santihofi/lit_compac_sky/macros/gilbert_cell/README.md

# gilbert_cell

Initial SKY130 schematic under characterization, not released for layout.
The conversion source is scripts/port_core_schematic.py at the repository root, with explicit sizing overrides in doc/porting/core_sizing.json when present.
See doc/porting/COMPARISON.md for measured candidates and qualification gaps.
No inherited IHP layout is a SKY130 deliverable.
