santihofi/lit_compac_sky/doc/porting/REVIEW-2026-11-10.md

# Input-2 evidence and bench review, 2026-11-10

The creator and independent reviewer were separate Codex agents using the same available model.
The runtime did not expose a more specific model revision.
This is an independent same-model review, not a stronger-model or cross-vendor review.

The reviewer read the scripts and raw Chipify outputs directly.
All 1440 older transmission-gate PVT rows matched the retained evidence.
The SS code search had three valid cases, 111 scalar measurements and twelve independently anchored AC curves.
Selected nominal results matched their raw runs.
Removing the loop probes and reconnecting split nodes restored the quiet-replica circuit for both benches.
Both main and replica tail gates are on the loaded side of the local bias probe.

Findings and changes:

- A failed future SS search could leave an old selected-code file. The analyzer now removes the previous selection before writing a new feasible selection.
- The loop analyzer did not require all five corners or match the selected parameter tuples. It now checks both, and the generator reads selected codes from the evidence.
- The new tuple check initially removed corner_mos from its indexed row. Keeping that column fixes the resulting KeyError.
- The PVT report called the measured tail-gate quantity a trim-gate rail. The wording now names the actual measured node.

The independent reviewer also reconstructed both FF and FS loop margins from their captured curves and found one unity crossing for each.
The PVT auditor now checks every declared parameter, including the defining quiet-replica geometry and mode, and reproduces the older 1440-case audit.
The reviewer subsequently anchored SF and SS too. The primary audit anchored all ten curves, but the separate TT review could not run because the reviewer reached its usage limit. The same independent reviewer completed the TT check on 2026-11-11, with no discrepancy.
On 2026-11-11 the reviewer checked all 1440 raw PVT rows, parameter grids and 45 coverage sets. The 32/45 DC coverage and thirteen-hole classification agree. Full-spec qualification remains open.

On 2026-11-11 the independent reviewer verified that the bias-sensitivity deck differs only in both ideal current sources and the tail-ratio normalization.
The generated grid contains the intended 150 cases at thirteen holes, including thirty factor-one controls.
A potential vacuous replay pass was found if a future datasheet omitted factor one.
The analyzer now requires the complete intended tuple set derived independently from the baseline coverage summary.

The independent reviewer also checked the refinement and resistor-range generators against the validated bias deck.
Refinement has fourteen cases and two repeated controls.
The resistor study has 180 cases across ten points, nine fixed/trim combinations and twenty repeated controls.
The endpoint analyzer reports gain span diagnostics and retains full-spec coverage as unverified.

The independent reviewer recomputed the final 40/45 DC union and all fourteen refinement rows with no numerical discrepancy.
The narrow TT shape margin is retained explicitly.
A robustness suggestion expanded the union's identity checks to every declared baseline parameter, including remaining transistor dimensions, passive models and reference conditions.

The independent reviewer checked all 180 resistor-range rows, twenty controls and ninety endpoint diagnostics with no discrepancy.
The proposed global 0.8 / 1.4 follow-up received an independent experimental-design review.
Separate review of its implementation remains pending because the reviewer reached its usage limit.
The primary checks confirm 322 generated cases, an unchanged circuit deck and unchanged parameters outside the intended resistor, code and bias fields.
Both preceding analyzer modes still reproduce their completed results.

The independent reviewer later completed the widened-network implementation and result review.
All 322 raw rows, twenty controls and ten all-code verdicts match the evidence.
The reviewer also checked the eight-code nominal AC generator and analyzer, including current substitutions, DC replay, four curves per code and matched IHP references.
No implementation defects were found. Numerical AC results remain pending.

The independent reviewer verified all eight widened-network AC rows, DC replays and 32 anchored curves.
Only FF and SF have a nominal joint pass at the tested currents.
The trim-poly diagnostic also passed independent topology review: all three decks are unchanged outside gain_trim, and exactly 35 resistor instances use resistance-matched family substitutions.
The reviewer confirmed both positive lengths and exact algebraic reduction of the wide-family replay equation.

The independent reviewer verified the four FS trim-poly rows, two wide-family replays, sixteen waveform anchors and both narrow-family joint passes.
The primitive probe implementation, model equations, lengths and capacitance sign convention were reviewed, but the reviewer did not independently replay that primitive simulation.
The sixteen-case corner extension and its complete tuple, replay and capture checks also passed implementation review.

On 2026-11-12 the independent reviewer verified all sixteen trim-corner rows, eight wide-family controls and 64 anchored curves.
The four-of-five nominal joint verdict agrees with the evidence.
SS remains below the bare and loaded input-2 references at both sampled codes.
The reviewer endorsed the finite SS gain/current search as a calibration experiment, with AC required at every DC-feasible setting before a joint verdict.

The independent reviewer verified the completed SS AC intersection and the active-pair sensitivity controls.
All four SS settings fail input-2 speed, with sixteen anchored curves and both old-current controls reproduced.
The four pair-width rows, two scale-one controls and sixteen curves also match the raw data.
The smaller-pair recalibration generator and DC analyzer passed implementation review, including the full 32-code grid and unchanged baseline parameters.

The independent reviewer verified both smaller-pair matched-gain AC rows, two DC replays and eight anchored curves.
Both SS codes pass the joint screen, with no inherited coverage from other geometries.
The twenty-case global endpoint generator and analyzer also passed implementation review, including fixed dummy loading, current settings, complete tuples and two SS endpoint controls.
