santihofi/lit_compac_sky/doc/porting/figures/input2_improvement.pdf

ff | fs | sf | ss | tt

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
Input-2 bandwidth / matched IHP bandwidth

100 fF per output, nominal MOS corners

2 copies, 5.73 µm fixed loads 6 copies, 1.41 µm fixed loads

in1
25 fF

in1
50 fF

in2
25 fF

in2
50 fF
Receiver input and wire capacitance per output

0.0

0.2

0.4

0.6

0.8

1.0

Input-2 bandwidth / matched IHP bandwidth

Slow corner, 1.41 µm loads in both variants

2 copies, identical receiver
6 copies, identical receiver

Six copies cost about 3× supply current and input capacitance versus two copies
