santihofi/lit_compac_sky/doc/README.md

# Documentation

Reference material for this chip and for the SkyWater sky130A Open-PDK it is built on.

## This chip

| Document | Contents |
| --- | --- |
| [specifications.md](specifications.md) | Top-level specifications: technology, supplies, clock, corner list, macro inventory, functional behaviour of every block. |
| [pinout.md](pinout.md) | The full 32-pad table per side, with the `lit_compac_top` port, the pad cell and the role each pad carries inside `lit_compac_core`. |
| [floorplan.md](floorplan.md) | Die and core geometry, hard-macro placement coordinates, the PDN strategy and the pad ring. |

The three are cross-linked and are written against the design files, not the other way round. If you change a number in [flow/librelane/config.yaml](../flow/librelane/config.yaml), [rtl/](../rtl/) or [packaging/config.yaml](../packaging/config.yaml), mirror it here.

## Tools

| Document | Contents |
| --- | --- |
| [klayout/klayout_cheatsheet.md](klayout/klayout_cheatsheet.md) | KLayout for this PDK: shortcuts, the `skywater130` PCell list, layer roles, the DRC and LVS menu entries and where they write. |
| [librelane/librelane_cheatsheet.md](librelane/librelane_cheatsheet.md) | LibreLane `final/` directory anatomy, non-default routing rules, the sky130A via and metal-stack tables read out of the tech LEF, the eight LEF/DEF orientations. |
| [verilog/](verilog/) | Verilog and SystemVerilog cheatsheets (external documents, PDK-independent). |

## PDK

| Document | Contents |
| --- | --- |
| [sky130A-Open-PDK/README.md](sky130A-Open-PDK/README.md) | Where the sky130 documentation lives, which commit of it this template was built against, and the layout numbers that matter, read out of the installed PDK. |
| [sky130A-Open-PDK/sky130A_ngspice_mc_mm_guide.md](sky130A-Open-PDK/sky130A_ngspice_mc_mm_guide.md) | How the ngspice model files fit together, what the `mc_mm_switch` and `mc_pr_switch` parameters do, and which corner, Monte Carlo and mismatch runs are possible per device family. |
| [sizing/](sizing/) | gm/ID techsweep plot overviews for the 1.8 V and 5 V MOS devices, the data behind the sizing notebooks in [macros/inverter/scripts/sizing/](../macros/inverter/scripts/sizing/). |

## Provenance and caveats

- **The PDK itself carries no PDF documentation.** sky130A has no `libs.doc/` folder, unlike the IHP PDKs, so this folder links the online documentation instead of copying it. The version this template was measured against is in [sky130A-Open-PDK/README.md](sky130A-Open-PDK/README.md): open_pdks `026824c7969ce6f4fc9678e6ca04b0a06a596c4b`, the PDK of the IIC-OSIC-TOOLS 2026.08 image.
- **Numbers here come from the installed PDK, not from a datasheet.** The metal stack table in the LibreLane cheatsheet is read out of `sky130_fd_sc_hd__nom.tlef`, the PCell list out of `libs.tech/klayout/python/cells/`, the corner sections out of `libs.tech/ngspice/sky130.lib.spice`. Re-read them after a PDK update, the commands are in each document.
- **Nothing in `doc/` is generated by a make target.** It is all hand-maintained, except the plot overviews in `sizing/`, which come from the techsweep data.
