santihofi/lit_compac_sky/ip/sky130_ip__jku/README.md

# sky130_ip__jku

A logo IP block for [Johannes Kepler University Linz](https://www.jku.at/), rendered as a GDSII layout on a configurable metal layer (default `met4`) for the SkyWater sky130A 130 nm CMOS process, framed by the `prBoundary` layer. sky130 has no fill keep-out layer like IHP's `NoMetFiller`, the chip flow handles the fill around the block.

## Directory Structure

<details>
<summary>Show Directory Structure</summary>

```text
📁 sky130_ip__jku/
├─ Makefile                   # Build automation
├─ 📁 logo/
│  └─ jku_logo.png            # Source PNG image
├─ 📁 script/
│  └─ img2lay.py              # PNG-to-GDS converter
├─ 📁 final/
│  ├─ 📁 gds/
│  │  └─ sky130_ip__jku.gds   # Generated GDSII layout
│  ├─ 📁 lef/
│  │  └─ sky130_ip__jku.lef   # LEF macro for place-and-route
│  ├─ 📁 lib/
│  │  └─ sky130_ip__jku.lib   # Liberty timing stub
│  └─ 📁 vh/
│     └─ sky130_ip__jku.vh    # Verilog blackbox stub
└─ 📁 verification/
   └─ 📁 drc/                 # DRC reports
```

</details>

## Usage

The default Make target is `help`, so running `make` prints usage and all available targets with short descriptions.

```bash
make
make help
```

Build everything (clean, generate logo GDS, LEF, Liberty, Verilog stub, run DRC):

```bash
make all
```

### PDK Guard

Every target except `help` and `clean` needs the `sky130A` PDK. A wrong `$PDK`, for example `ihp-sg13g2` from the sibling IHP template, splits the IP across two technologies: `img2lay.py` resolves the `LAYER` name through the layer properties of the active PDK, and `sak-drc.sh` runs the DRC against its rule deck, while the metal stack the logo is meant for is the sky130 one. The Makefile therefore compares `$PDK` against `REQUIRED_PDK` once when it is parsed, before any target runs:

```bash
$ sak-pdk ihp-sg13g2
$ make all
Makefile:21: *** PDK is "ihp-sg13g2", but this IP needs "sky130A". Run `sak-pdk sky130A` in this shell and retry, or pass REQUIRED_PDK= to skip this check.  Stop.
```

The check is a parse-time conditional at the top of the Makefile, not a prerequisite of each target. Switch the PDK with `sak-pdk sky130A`, pass `REQUIRED_PDK=` to skip the check, or `REQUIRED_PDK=<pdk>` to require a different PDK.

### Individual Targets

| Target | Description |
|---|---|
| `logo` | Convert PNG to GDSII using `img2lay.py` |
| `lef` | Generate LEF macro (CLASS BLOCK, OBS on `$(LAYER)`) |
| `lib` | Generate Liberty timing stub (empty cell) |
| `verilog` | Generate Verilog blackbox stub (no ports) |
| `klayout-drc` | Run KLayout DRC using `sak-drc.sh` (usage: `make klayout-drc [CELL=<cellname>] [DRC_LEVEL=<precheck\|macro\|regular>]`) |
| `magic-drc` | Run Magic DRC using `sak-drc.sh` (usage: `make magic-drc [CELL=<cellname>]`) |
| `open` | Browse this folder with `sak-open.py` and open each file in its tool |
| `clean` | Remove all generated output directories |

### Parameters

The following Makefile variables can be overridden:

| Variable | Default  | Description |
|---|---|---|
| `BLOCK_SIZE`  | `100` | Block edge in µm, the image is scaled to it |
| `PIXEL_SIZE`  | `0.50` | Pixel size in µm (must be ≥ 0.3 µm, the `met4` minimum width and space, single pixels and single-pixel gaps are drawn as is; `met5` needs 1.6 µm) |
| `LAYER` | `met4` | Metal layer the logo is drawn on, one of `met1`..`met5` |

Setting `LAYER` keeps the GDS artwork (`logo` target) and the LEF obstruction (`lef` target) consistent. The `logo` target hands the name to `img2lay.py`, which resolves it through the PDK's KLayout layer properties (`met4` is `71/20`), and the `lef` target writes the same name into the `OBS`.

```sh
make all LAYER=met5 PIXEL_SIZE=2
```

The image is scaled to `BLOCK_SIZE`, so the GDS boundary and the LEF `SIZE` always agree.

## Logo Generator Script

The `script/img2lay.py` script converts a PNG image into a GDSII layout:

- Each horizontal run of dark pixels becomes a rectangle on the layer selected via `LAYER` (default `met4`, resolved to `71/20`)
- The boundary layer `prBoundary` (235/4) marks the block outline
- Layers are given as `<layer>/<datatype>` or as a layer name of the active PDK, read from `$PDK_ROOT/$PDK/libs.tech/klayout/tech/<pdk>.lyp`. sky130A names its entries `met4.drawing - 71/20`, a bare name selects the drawing purpose (or the only purpose, `prBoundary` is `prBoundary.boundary`), `<layer>.<purpose>` selects any other
- `--invert` inverts the image (dark ↔ light)
- `--merge` merges the rectangles into polygons to reduce the polygon count
- `--pixel-size` sets the physical size of each pixel in µm
- `--block-size` scales the image to the given block edge in µm and draws the boundary layers at that size
- `--scale` downscales the image by a plain factor instead

## Design Rule Check (DRC)

Runs DRC on the GDS layout in `final/gds/`. Both flows use `sak-drc.sh` and write to `verification/drc/`: Magic into the run folder `verification/drc/<CELL>.magic.drc/` (`<CELL>.magic.drc.rpt`), KLayout directly into `verification/drc/` as one marker database and log per deck, `<CELL>.klayout.drc.<deck>.xml` and `.log` with `<deck>` being `feol`, `beol`, `pincheck` or `zeroarea`.

**KLayout DRC** uses `sak-drc.sh` at the selected `DRC_LEVEL` (`precheck`, `macro` [default], or `regular`):

```sh
make klayout-drc
make klayout-drc CELL=sky130_ip__jku
make klayout-drc DRC_LEVEL=regular
```

**Magic DRC** uses `sak-drc.sh`:

```sh
make magic-drc
make magic-drc CELL=sky130_ip__jku
```
