santihofi/lit_compac_sky/doc/porting/figures/ihp_core_transfer.pdf

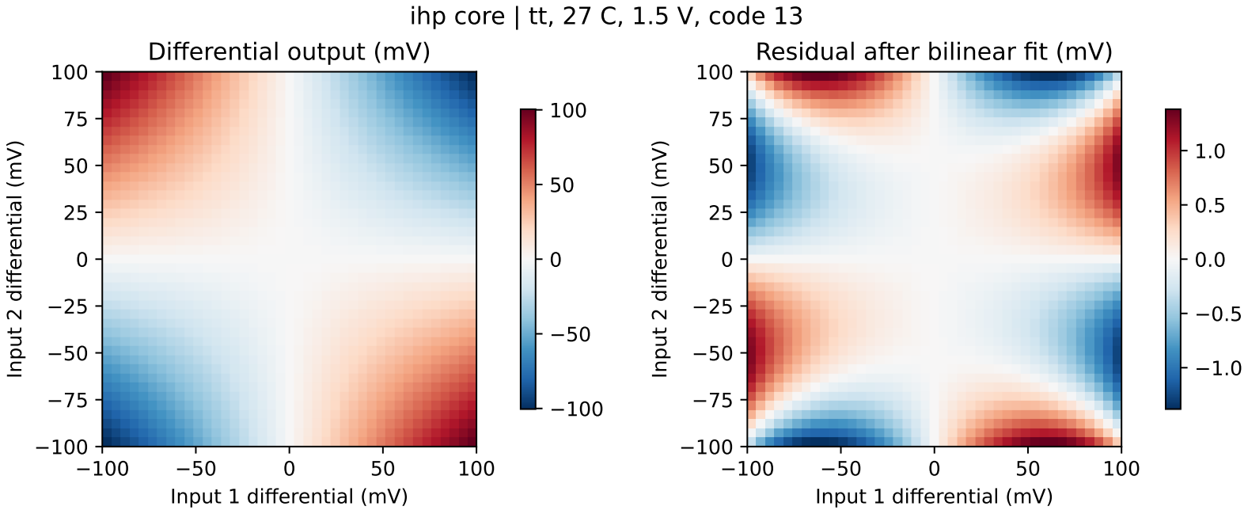
[picture p19: page 1]

−100 | −50 | 0 | 50 | 100
Input 1 differential (mV)

−100

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
Input 2 di

fferential (mV)

### Differential output (mV)

−100 | −50 | 0 | 50 | 100
Input 1 differential (mV)

−100

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
Input 2 di

fferential (mV)

### Residual after bilinear fit (mV)

−100

−50

0

50

100

−1.0

−0.5

0.0

0.5

1.0

### ihp core | tt, 27 C, 1.5 V, code 13
