santihofi/lit_compac_sky/doc/porting/figures/ihp_surface_corners.png

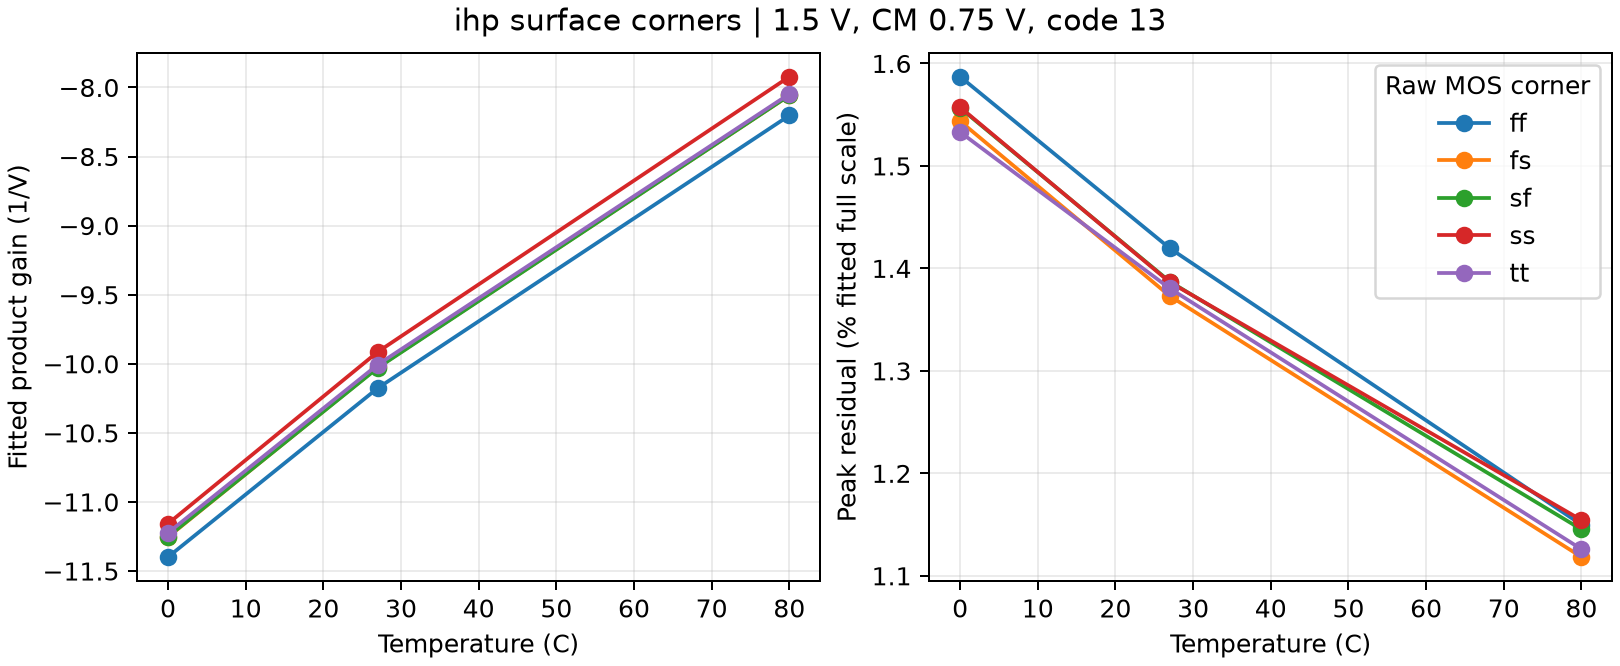
doc/porting/figures/ihp_surface_corners.png
