santihofi/lit_compac_sky/doc/porting/figures/replica_schematic_gain_trim.png

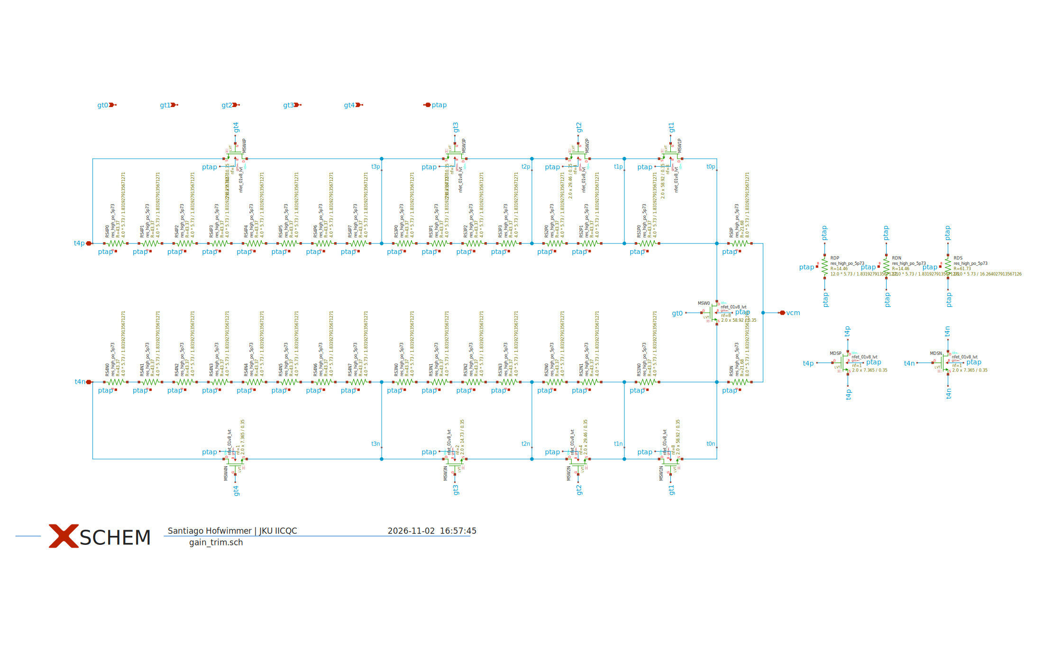
doc/porting/figures/replica_schematic_gain_trim.png
