santihofi/lit_compac_sky/doc/porting/figures/replica_schematic_gilbert_cell.png

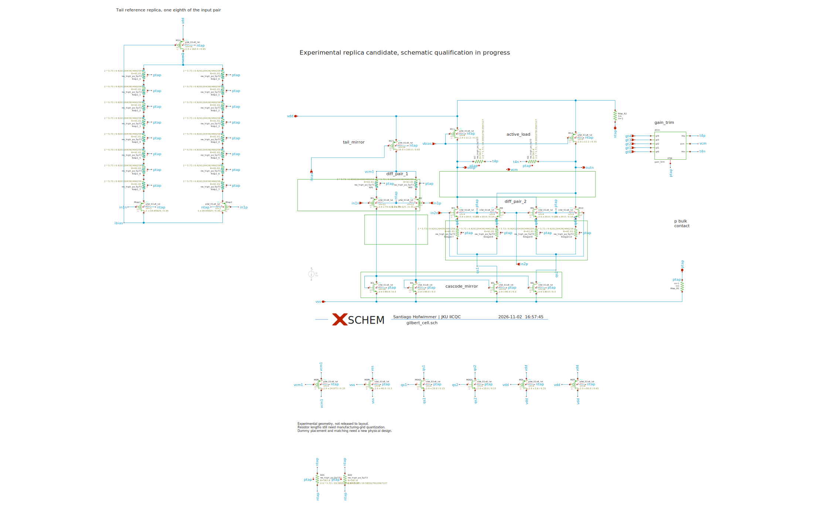
doc/porting/figures/replica_schematic_gilbert_cell.png
