santihofi/lit_compac_sky/doc/porting/figures/replica_schematic_ota.png

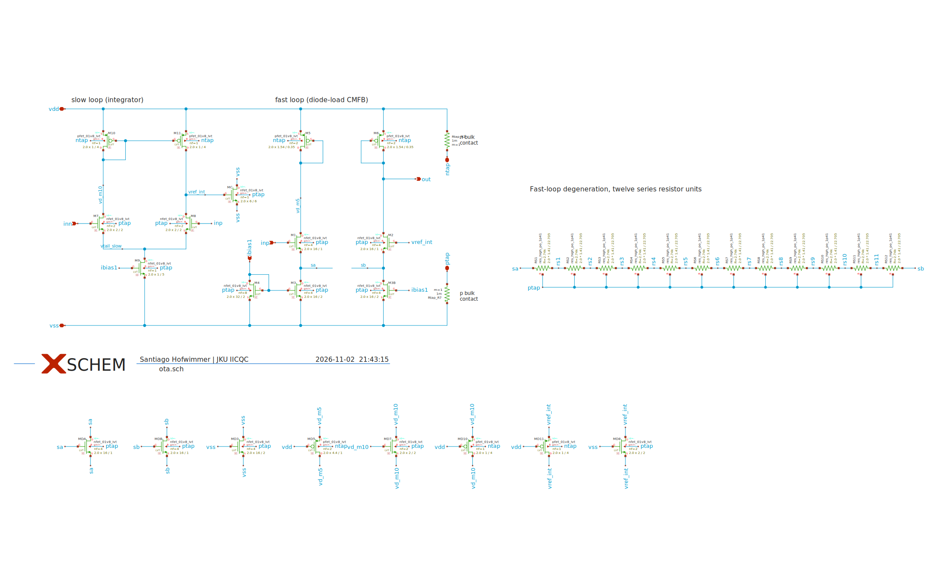
doc/porting/figures/replica_schematic_ota.png
