santihofi/lit_compac_sky/doc/porting/figures/sky_replica_surface_corners.png

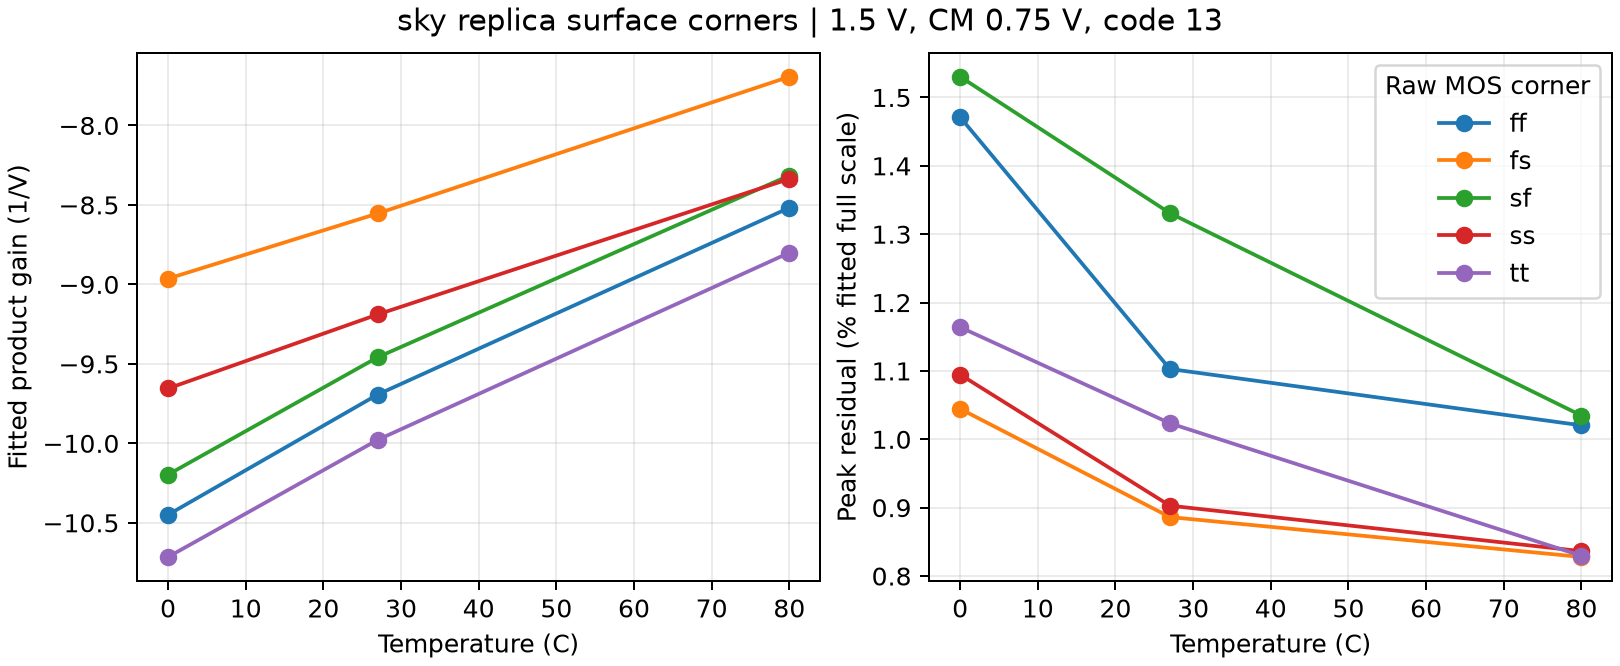
doc/porting/figures/sky_replica_surface_corners.png
