santihofi/lit_compac_sky/macros/counter/render/img/counter_top_black.png

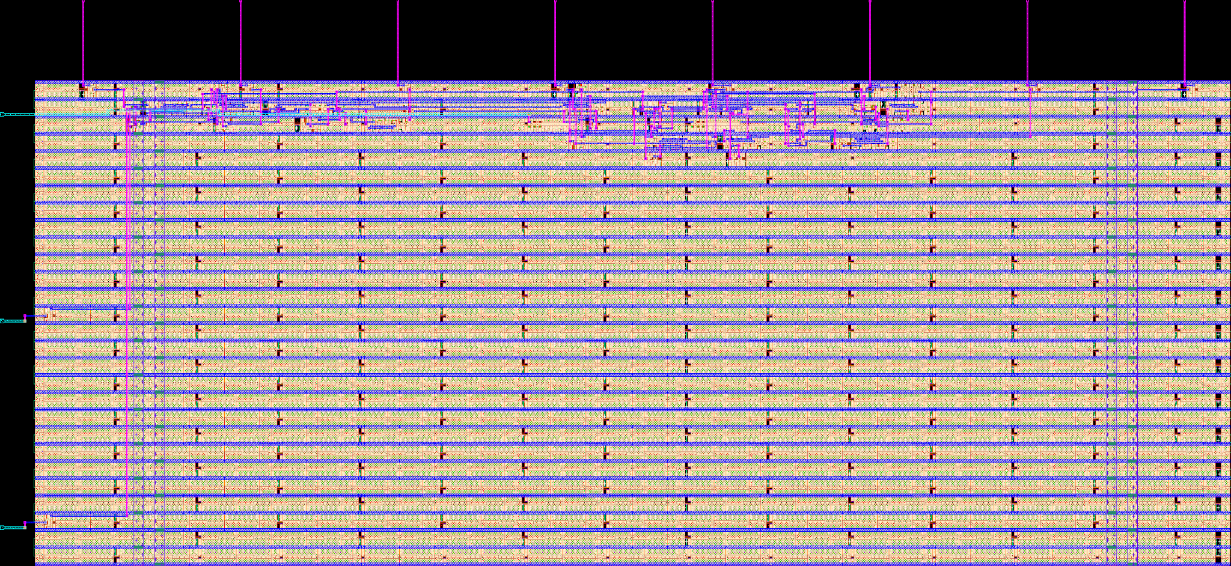
macros/counter/render/img/counter_top_black.png
