santihofi/lit_compac_sky/macros/counter/render/img/counter_top_librelane.png

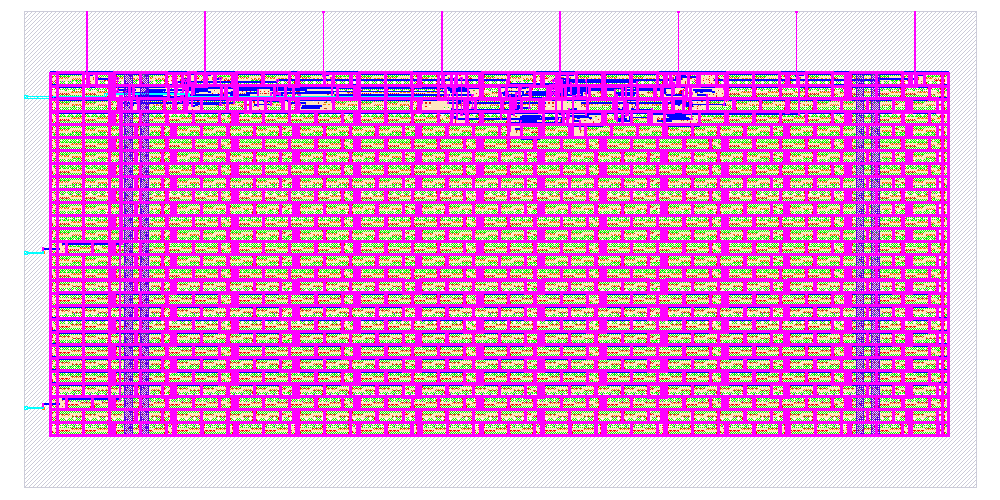
macros/counter/render/img/counter_top_librelane.png
