santihofi/lit_compac_sky/macros/inverter/render/img/inverter_top_black.png

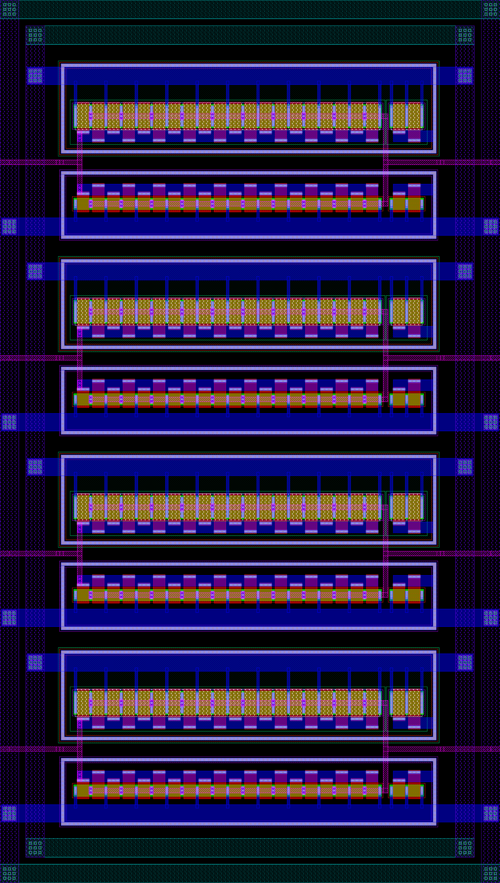
macros/inverter/render/img/inverter_top_black.png
