santihofi/lit_compac_sky/verification/porting/sky_input2_pair_global_codes/README.md

# Global smaller-pair gain-code screen

Use one trim factor 1.7, fixed-load factor 0.8 and active-pair scale 2/3 at all ten operating points.
All 32 codes are swept, with twenty endpoints available as replay controls.
Nominal SS and hot points use bias factor 0.9, cold TT uses 0.85 and other nominal corners use 1.
These 320 cases test joint DC feasibility on a subset of PVT.
Same-setting AC, noise and stability remain necessary before a circuit acceptance verdict.
