santihofi/lit_compac_sky/verification/porting/sky_input2_pair_trim_range/README.md

# Smaller-pair global trim-range controls

At fixed base-load factor 0.8, compare trim factors 1.4, 1.6, 1.65 and 1.7.
The smaller active pair, fixed four-finger dummy and 2.85 um trim family apply globally.
The same ten operating points and bias factors are retained.
Eighty endpoint cases include twenty factor-1.4 replay controls.
Any selected trim factor must be global, followed by gain/current calibration and same-setting AC.
Endpoint span alone does not establish a joint passing code.
