santihofi/lit_compac_sky/verification/porting/sky_input2_pair_width/README.md

# Active input-pair width with fixed dummy loading

At SS, 27 C, 1.5 V and bias factor 0.9, compare pair scales 2/3 and 1 at codes 10 and 11.
The main pair has eight or twelve fingers and the one-eighth replica has six or nine fingers with six circuit copies.
XMDP retains its original four fingers and width, preventing fractional dummy geometry and keeping its absolute loading fixed.
The identical downstream receiver uses the same active-pair width.
All other geometry, current sources and resistor factors remain unchanged.
The scale-one cases must reproduce the preceding circuit.
This is fixed-code sensitivity, not matched-gain calibration or physical sign-off.
