santihofi/lit_compac_sky/verification/porting/sky_input2_trim_ss_bias/README.md

# Nominal SS gain and bias search

The narrow trim-poly candidate keeps all geometry, reference voltage and resistor factors unchanged.
All 32 gain codes are evaluated at five ideal current factors from 0.8 to 1.2.
Both reference current sources scale together.
Codes 11 and 12 at factor 1 replay the preceding narrow-poly SS cases.
The DC-feasible set must subsequently be intersected with bare and receiver-loaded bandwidth at identical settings.
This discrete bias search does not exhaust arbitrary current values or physical DAC behavior.
