santihofi/lit_compac_sky/verification/porting/sky_input2_quiet_trim_poly/README.md

# Resistance-matched narrow trim poly control

Only the gain-trim subcircuit's 32 segment devices and three dummies change poly family.
Both widths match the target zero-voltage unit resistance at 27 C using the installed end-corrected model and longer positive quadratic root.
The widened trim unit is large enough for a positive 2.85 um family length.
The 1.41 um fixed core loads, source resistors, switches, transistor geometry, currents and codes remain unchanged.
Two 5.73 um cases replay the previous FS nominal codes.
The identical receiver uses the same candidate trim family.
These are continuous model lengths, not layout or mismatch qualification.
Resistance matching alone does not preserve voltage coefficient, temperature coefficient or shape.
