santihofi/lit_compac_sky/verification/porting/sky_input2_quiet_range/README.md

# Quiet-replica resistor-range endpoint screen

Nine fixed-load and trim-resistance combinations are tested at five nominal MOS points and five difficult PVT points.
Fixed-load factors are 0.8, 0.9 and 1, while trim factors are 1, 1.2 and 1.4.
All use the existing quiet-replica geometry and 1.41 um fixed-load resistor family.
Nominal points retain the earlier ideal bias, while difficult points use the sampled factor 0.9.
Both code endpoints are measured, including the unchanged resistor-network control.
Endpoint gain coverage is only a range diagnostic.
It does not prove an intermediate code satisfying shape, speed, noise and stability.
A selected resistor combination must apply globally before repeating per-PVT calibration.
