santihofi/lit_compac_sky/verification/porting/sky_input2_quiet_bias/README.md

# Quiet-replica bias sensitivity at uncovered PVT points

At each uncovered point, test gain-code endpoints and the earlier nearest-gain code.
Scale both ideal unit-current sources by 0.8, 0.9, 1, 1.1 and 1.2.
The factor-one rows replay the prior exhaustive code sweep.
Other transistor, resistor, reference and trim settings remain unchanged.
This is a sparse sensitivity screen, not exhaustive bias or gain-code coverage.
Any promising bias setting still needs a complete gain-code search and same-code speed, noise and loop checks.
