santihofi/lit_compac_sky/verification/porting/ihp_input2_fanout/README.md

Matched IHP slow-N/fast-P receiver-loading control at nominal voltage and temperature.
