santihofi/lit_compac_sky/verification/porting/ihp_input2_quiet_reference/README.md

# IHP receiver-load reference for quiet-replica comparison

Each nominal MOS corner uses its earlier nearest K100 code.
The driver feeds input 1 of an identical receiver, with 25 fF wire capacitance per output.
SKY130 fs/sf labels must be reversed when joining this reference.
