santihofi/lit_compac_sky/verification/porting/sky_input2_candidate/README.md

# Six-copy narrow-load candidate

Six copies are the smallest tested integer-finger option passing the slow-corner fixed-load bandwidth screen.
The fixed loads use resistance-matched 1.41 um precision poly.
Each MOS corner retains the earlier unit-current setting and nearest nominal gain code.
The release control is the previously measured two-copy fs point.
The earlier five-copy nominal folder is diagnostic only because its replica finger count was truncated.
This is a nominal gain, shape and fixed-load bandwidth screen, not complete schematic acceptance.
