santihofi/lit_compac_sky/verification/porting/sky_input2_load_resistors/README.md

# Equal-resistance load geometry screen

Only the two fixed core loads and their two dummy resistors change family.
Their target zero-voltage resistance is matched at 27 C using the installed model's end and body expressions.
The longer positive quadratic root is used for the two narrower families.
The trim segments and source resistors retain the 5.73 um family.
This is a nominal model-level geometry screen with continuous lengths, not layout or mismatch qualification.
A 5.73 um replay control must reproduce the earlier design.
The narrower families have different voltage coefficients and statistical behavior, so matching resistance does not imply interchangeable devices.
