santihofi/lit_compac_sky/verification/porting/sky_trim_tg2_ac/README.md

# Transmission-gate feasible-code AC screen

The generator imports the exact three subcircuits from the nominal DC code study.
Every code passing its provisional gain, shape and gate-rail screen receives the same two-input AC and input-capacitance measurements.
Ideal reference currents, complementary gate controls and nominal passive models remain in use.
This experiment does not establish full PVT or physical calibration performance.
