santihofi/lit_compac_sky/verification/porting/sky_trim_switch_lengths/README.md

# Trim-switch NMOS length control

This extends sky_trim_switch_probe by changing only the NMOS channel length.
The PMOS-only fixtures remain unchanged as controls.
Lengths are 0.15, 0.35, 0.5 and 1 um, with all unit widths fixed at 7.365 um.
This measures on-resistance and supply sensitivity, not mismatch or circuit bandwidth.
