santihofi/lit_compac_sky/verification/porting/sky_trim_switch_probe/README.md

# Mid-rail trim-switch conductance

Five independent fixtures measure the differential conductance of a low-threshold NMOS, one or two parallel low-threshold PMOS devices, and their transmission-gate combinations.
Every unit is W=7.365 um, L=0.35 um, nf=1.
All switches are on, with NMOS gates at VDD and PMOS gates at zero.
Each source/drain pair stays centered at 0.75 V with 1 mV differential bias.
A native DC sweep varies VDD from 1.45 to 1.65 V.

The probe compares five MOS corners at 27 C.
It does not measure mismatch, switch capacitance, signal-amplitude distortion or the complete multiplier.
