santihofi/lit_compac_sky/verification/porting/sky_trim_gate_ac/README.md

# Independent trim-drive diagnostic

This control holds the wider candidate at sf, 1.45 V and gain code 10, then varies only the ideal high rail of its five trim drivers.
The 1.45 V setting reproduces the circuit-supply-driven case.
The 1.5 V and 1.65 V settings deliberately separate switch drive from circuit supply.
Those over-rail settings diagnose sensitivity and are not proposed chip interfaces.
All transistor dimensions, loads and ideal bias currents stay fixed.
