santihofi/lit_compac_sky/macros/inverter/testbenches/xschem/plot_simulations/figures/inverter_tb_ac_ol.pdf

### Inverter - AC Open-Loop Response

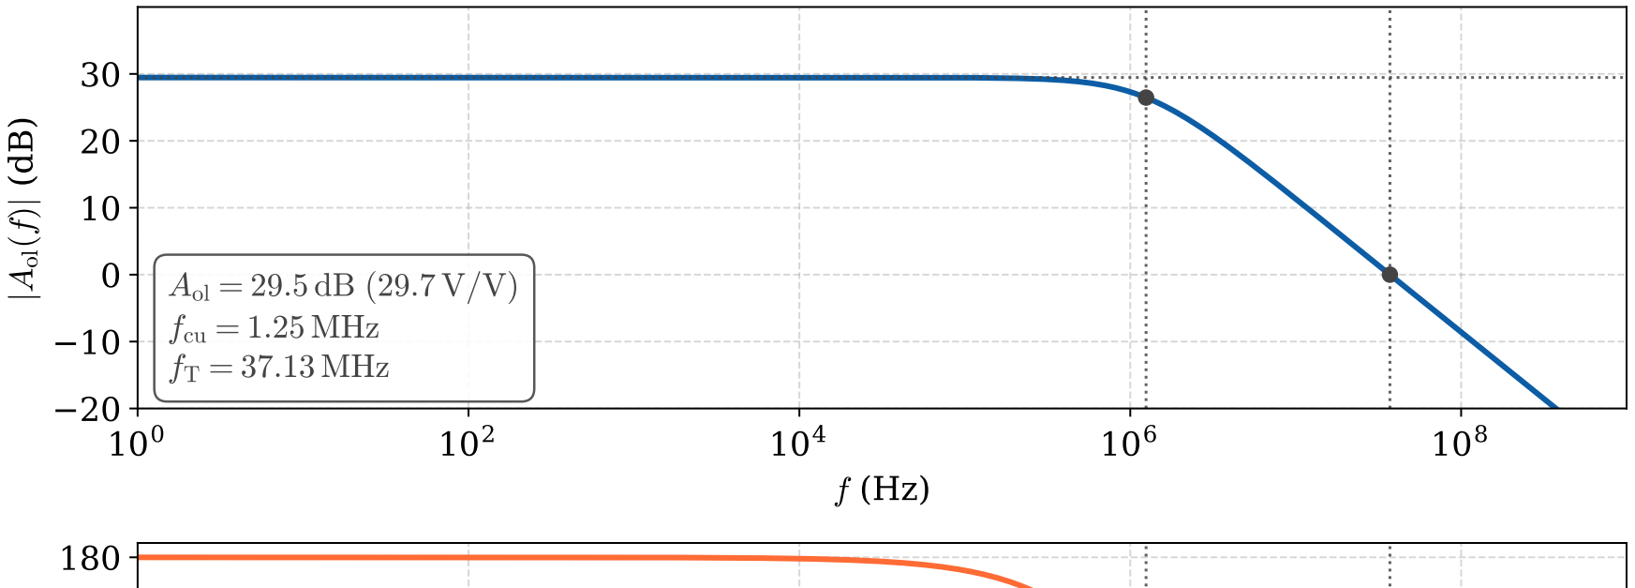
[picture p28: figure]
jAol(f)j (d; Aol = 29:5 dB (29:7 V=V) fcu = 1:25 MHz; fT = 37:13 MHz
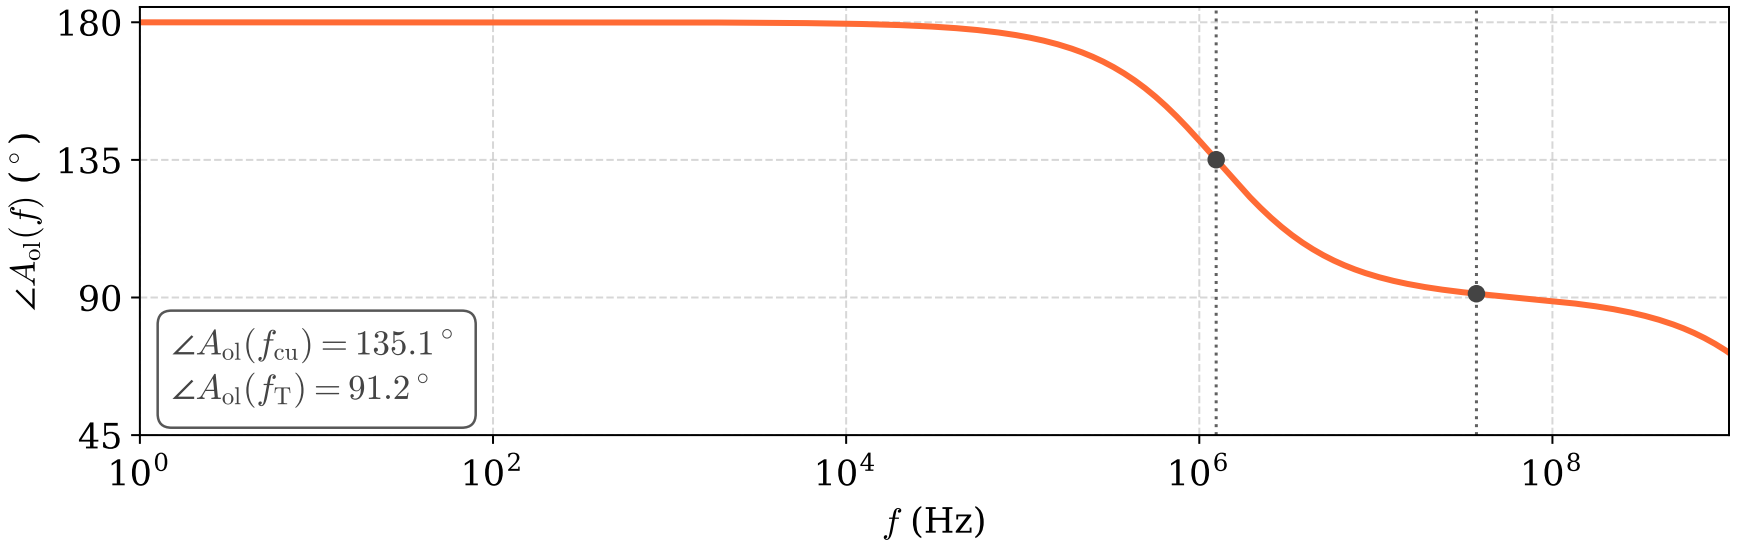
[picture p29: figure]
Aol(f) (; ∠Aol(fcu) = 135:1; ∠Aol(fT) = 91:2
