santihofi/lit_compac_sky/verification/porting/sky_input2_pair_endpoints/README.md

# Global smaller-pair endpoint screen

The smaller active-pair geometry and fixed dummy loading apply at every test point.
The five nominal MOS corners and five difficult PVT points are tested at gain-code endpoints.
Bias settings follow the preceding widened-network screen, except nominal SS uses its measured factor 0.9.
Nominal SS endpoints replay the completed smaller-pair 32-code sweep.
Endpoint span is a range diagnostic, not a joint code or full-PVT verdict.
Prior results from larger input pairs cannot establish coverage of this geometry.
