santihofi/lit_compac_sky/macros/inverter/verification/cace/scripts/inverter_tb_ac.csv

Adc_ol_dB_arr | fcu_arr
2.922990000000000066e+01 | 1.276290000000000000e+06
2.949449999999999861e+01 | 1.248090000000000000e+06
2.858960000000000079e+01 | 1.373320000000000000e+06
3.087839999999999918e+01 | 1.072770000000000000e+06
2.790390000000000015e+01 | 1.478740000000000000e+06
2.911949999999999861e+01 | 1.298930000000000000e+06
3.303820000000000334e+01 | 8.457830000000000000e+05
2.887389999999999901e+01 | 1.321100000000000000e+06
2.727670000000000172e+01 | 1.579230000000000000e+06
2.937440000000000140e+01 | 1.257700000000000000e+06
3.071890000000000143e+01 | 1.098120000000000000e+06
2.857819999999999894e+01 | 1.364370000000000000e+06
2.904220000000000113e+01 | 1.308480000000000000e+06
3.015940000000000154e+01 | 1.160440000000000000e+06
2.750130000000000052e+01 | 1.535540000000000000e+06
2.852100000000000080e+01 | 1.371110000000000000e+06
2.925850000000000151e+01 | 1.266350000000000000e+06
2.988390000000000057e+01 | 1.196770000000000000e+06
2.836809999999999832e+01 | 1.393660000000000000e+06
2.943560000000000088e+01 | 1.238040000000000000e+06
2.925529999999999831e+01 | 1.268780000000000000e+06
2.971569999999999823e+01 | 1.196920000000000000e+06
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
