santihofi/lit_compac_sky/macros/inverter/testbenches/xschem/plot_simulations/figures/inverter_tb_dc_vout.csv

vin | vout | dvout_dvin
0.000000000000000000e+00 | 1.800000239999999918e+00 | 0.000000000000000000e+00
1.000000000000000021e-03 | 1.800000239999999918e+00 | 0.000000000000000000e+00
2.000000000000000042e-03 | 1.800000239999999918e+00 | 0.000000000000000000e+00
3.000000000000000062e-03 | 1.800000239999999918e+00 | 0.000000000000000000e+00
4.000000000000000083e-03 | 1.800000239999999918e+00 | -4.999999987376213539e-06
5.000000000000000104e-03 | 1.800000229999999979e+00 | -4.999999987376213539e-06
6.000000000000000125e-03 | 1.800000229999999979e+00 | 0.000000000000000000e+00
7.000000000000000146e-03 | 1.800000229999999979e+00 | 0.000000000000000000e+00
8.000000000000000167e-03 | 1.800000229999999979e+00 | -1.136868377216160297e-13
8.999999999999999320e-03 | 1.800000229999999979e+00 | -5.000000214749888983e-06
1.000000000000000021e-02 | 1.800000220000000040e+00 | -4.999999760002538096e-06
1.099999999999999936e-02 | 1.800000220000000040e+00 | -2.273736754432320595e-13
1.200000000000000025e-02 | 1.800000220000000040e+00 | 2.273736754432320595e-13
1.299999999999999940e-02 | 1.800000220000000040e+00 | -2.273736754432320595e-13
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
