santihofi/lit_compac_sky/macros/inverter/testbenches/xschem/plot_simulations/figures/inverter_top_tb_tran.csv

time_ms | vin | vout1 | vout2 | vout3 | vout4
0.000000000000000000e+00 | 9.000000000000000222e-01 | 1.260963309999999948e+00 | 1.260963309999999948e+00 | 1.260963309999999948e+00 | 1.260963309999999948e+00
1.000000000000000082e-05 | 9.000006280000000247e-01 | 1.260961959999999937e+00 | 1.260961959999999937e+00 | 1.260961959999999937e+00 | 1.260961959999999937e+00
2.000000000000000164e-05 | 9.000012569999999990e-01 | 1.260959340000000095e+00 | 1.260959340000000095e+00 | 1.260959340000000095e+00 | 1.260959340000000095e+00
4.000000000000000327e-05 | 9.000025130000000040e-01 | 1.260951350000000026e+00 | 1.260951350000000026e+00 | 1.260951350000000026e+00 | 1.260951350000000026e+00
8.000000000000000654e-05 | 9.000050269999999575e-01 | 1.260924189999999889e+00 | 1.260924189999999889e+00 | 1.260924189999999889e+00 | 1.260924189999999889e+00
1.600000000000000131e-04 | 9.000100530000000321e-01 | 1.260837339999999918e+00 | 1.260837339999999918e+00 | 1.260837339999999918e+00 | 1.260837339999999918e+00
3.200000000000000262e-04 | 9.000201060000000419e-01 | 1.260594870000000034e+00 | 1.260594870000000034e+00 | 1.260594870000000034e+00 | 1.260594870000000034e+00
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
