santihofi/lit_compac_sky/doc/porting/evidence/calibrated_pvt_matched.csv

temp | seed_sky | vdd | vincm_sky | vref_sky | corner_mos_sky | corner_res_sky | corner_cap_sky | gcode_sky | ibias_sky | c_load_sky | vd1_sky | vd2_sky | mirror_scale | mirror_l | pair_scale | pair_l | quad_scale | quad_l | rscale | power_m | quad_model | body_tied | native_nf | rquad | tail_width | rpair | pload_l | tail_length_scale | pair_body_tied | rbase_scale | rtrim_scale | sim_error_sky | run_id_sky | ac__error | bw_in1_mhz_sky | bw_in1_mhz_pass_sky | bw_in2_mhz_sky | bw_in2_mhz_pass_sky | acgain_in1_sky | acgain_in1_pass_sky | acgain_in2_sky | acgain_in2_pass_sky | cin1_per_pin_ff | cin1_per_pin_ff_pass | cin2_per_pin_ff | cin2_per_pin_ff_pass | cin1_100mhz_ff | cin1_100mhz_ff_pass | cin2_100mhz_ff | cin2_100mhz_ff_pass | idd_sky | idd_pass_sky | ac_overall_pass | global_pass_sky | datasheet_sky | matched_corner | seed_ihp | vincm_ihp | vref_ihp
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
