santihofi/lit_compac_sky/doc/porting/evidence/ihp_calibrated_pvt.csv

temp | seed | vdd | vincm | vref | corner_mos | corner_res | corner_cap | gcode | ibias | c_load | vd1 | vd2 | gate_tracks_vdd | sim_error | run_id | core__error | k100 | k100_pass | k10 | k10_pass | compr | compr_pass | vocm | vocm_pass | idd | idd_pass | vos | vos_pass | tail_margin | tail_margin_pass | pair_margin | pair_margin_pass | mirror_margin | mirror_margin_pass | quad_margin | quad_margin_pass | qs | qs_pass | sp | sp_pass | bw_in1_mhz | bw_in1_mhz_pass | bw_in2_mhz | bw_in2_mhz_pass | acgain_in1 | acgain_in1_pass | acgain_in2 | acgain_in2_pass | core_overall_pass | global_pass | datasheet
0 | 0.0 | 1.5 | 0.75 | 0.75 | ff | typ | typ | 11 | 40u | 100f | 0 | 0 | 1 |  | 000001 |  | -11.1831 | True | -10.9167 | True | 1.0244 | True | 0.757778 | True | 0.000734233 | True | -2.60902e-14 | True | 0.10694 | True | 0.670727 | True | 0.172894 | True | 0.242167 | True | 0.379772 | True | 1.24964 | True | 455.574 | True | 881.649 | True | 1.15522 | True | 1.06622 | True | True | True | calibrated_ff.yaml
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
