santihofi/lit_compac_sky/doc/porting/evidence/ihp_gain_calibration.csv

temp | seed | vdd | vincm | vref | corner_mos | corner_res | corner_cap | gcode | ibias | c_load | vd1 | vd2 | gate_tracks_vdd | sim_error | run_id | core__error | k100 | k100_pass | k10 | k10_pass | compr | compr_pass | vocm | vocm_pass | idd | idd_pass | vos | vos_pass | tail_margin | tail_margin_pass | pair_margin | pair_margin_pass | mirror_margin | mirror_margin_pass | quad_margin | quad_margin_pass | qs | qs_pass | sp | sp_pass | bw_in1_mhz | bw_in1_mhz_pass | bw_in2_mhz | bw_in2_mhz_pass | acgain_in1 | acgain_in1_pass | acgain_in2 | acgain_in2_pass | core_overall_pass | global_pass | datasheet
27 | 0.0 | 1.5 | 0.75 | 0.75 | ff | typ | typ | 0 | 40u | 100f | 0 | 0 | 1 |  | 0 |  | -8.79279 | True | -8.66013 | True | 1.01532 | True | 0.758353 | True | 0.000739553 | True | -1.26454e-13 | True | 0.105571 | True | 0.651194 | True | 0.165028 | True | 0.221766 | True | 0.38961 | True | 1.24098 | True | 458.646 | True | 1019.34 | True | 0.905388 | True | 0.845784 | True | True | True | lab_steps_ff
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
