santihofi/lit_compac_sky/doc/porting/evidence/sky_bias_calibration_pvt.csv

temp | seed | vdd | vincm | vref | corner_mos | corner_res | corner_cap | gcode | ibias | c_load | vd1 | vd2 | mirror_scale | mirror_l | pair_scale | pair_l | quad_scale | quad_l | rscale | power_m | quad_model | body_tied | native_nf | rquad | tail_width | sim_error | run_id | curvature__error | k100 | k100_pass | k10 | k10_pass | compr | compr_pass | vocm | vocm_pass | idd | idd_pass | vos | vos_pass | tail_margin | tail_margin_pass | pair_margin | pair_margin_pass | mirror_margin | mirror_margin_pass | quad_margin | quad_margin_pass | qs | qs_pass | sp | sp_pass | kaxis1 | kaxis1_pass | kaxis2 | kaxis2_pass | axis1 | axis1_pass | axis2
0 | 0.0 | 1.45 | 0.75 | 0.75 | ff | typ | typ | 13 | 3.0000000000000004e-05 | 100f | 0 | 0 | 8 | 0.3 | 0.5 | 0.35 | 4 | 0.15 | 1.3 | 4 | nfet_01v8_lvt | 0 | 1 | 180 | 2 |  | 0 |  | -9.81369 | True | -9.7251 | True | 1.00911 | True | 0.752523 | True | 0.00190043 | True | -3.33598e-11 | True | 0.143775 | True | 0.547076 | True | 0.166327 | True | 0.481902 | True | 0.215624 | True | 1.20963 | True | -9.49692 | True | -10.2786 | True | 0.976537 | True | 1.05692
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
