santihofi/lit_compac_sky/doc/porting/evidence/sky_calibrated_transfer_surface.csv

sweep | v(vdin1) | v(vdin2) | outdiff | vocm
-0.1 | -0.1 | -0.1 | -0.0974103092 | 0.753115247
-0.095 | -0.095 | -0.1 | -0.0928035723 | 0.753066655
-0.09 | -0.09 | -0.1 | -0.088156482 | 0.753019953
-0.085 | -0.085 | -0.1 | -0.0834711135 | 0.752975231
-0.08 | -0.08 | -0.1 | -0.0787495495 | 0.752932574
-0.075 | -0.075 | -0.1 | -0.0739938823 | 0.752892064
-0.07 | -0.07 | -0.1 | -0.0692062095 | 0.75285378
-0.065 | -0.065 | -0.1 | -0.0643886347 | 0.752817795
-0.06 | -0.06 | -0.1 | -0.059543265 | 0.752784179
-0.055 | -0.055 | -0.1 | -0.0546722096 | 0.752752997
-0.05 | -0.05 | -0.1 | -0.0497775816 | 0.752724311
-0.045 | -0.045 | -0.1 | -0.0448614939 | 0.752698177
-0.04 | -0.04 | -0.1 | -0.0399260612 | 0.752674647
-0.035 | -0.035 | -0.1 | -0.0349733982 | 0.752653767
-0.03 | -0.03 | -0.1 | -0.0300056204 | 0.75263558
-0.025 | -0.025 | -0.1 | -0.0250248426 | 0.752620124
-0.02 | -0.02 | -0.1 | -0.0200331811 | 0.75260743
-0.015 | -0.015 | -0.1 | -0.0150327502 | 0.752597526
-0.01 | -0.01 | -0.1 | -0.0100256662 | 0.752590433
-0.005 | -0.005 | -0.1 | -0.00501404404 | 0.75258617
1.5612511299999998e-17 | 1.5612511299999998e-17 | -0.1 | 2.17270091e-10 | 0.752584746
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
