santihofi/lit_compac_sky/macros/inverter/verification/cace/results/inverter/Adc_ol_dB_mm.png

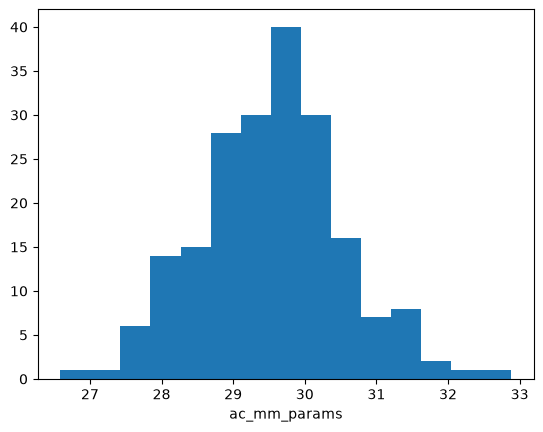
macros/inverter/verification/cace/results/inverter/Adc_ol_dB_mm.png
