santihofi/lit_compac_sky/macros/inverter/verification/cace/results/inverter/fcu_mm.png

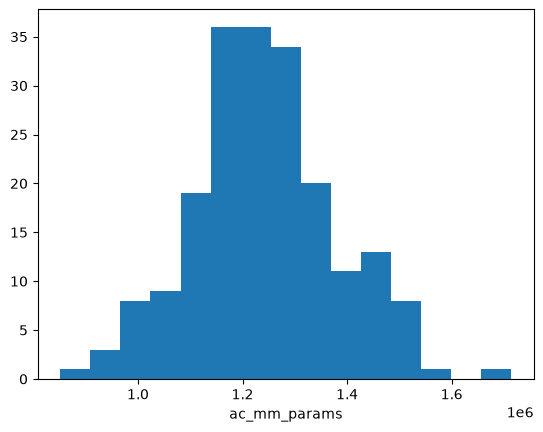
macros/inverter/verification/cace/results/inverter/fcu_mm.png
