santihofi/lit_compac_sky/macros/inverter/verification/cace/results/inverter/fcu_vs_vdd.png

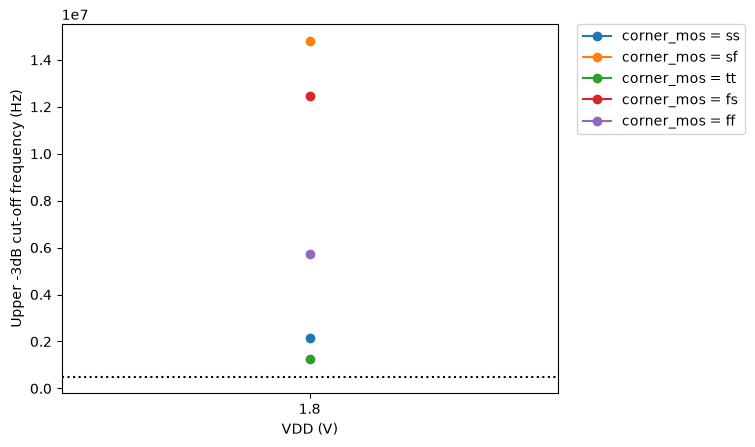
macros/inverter/verification/cace/results/inverter/fcu_vs_vdd.png
