santihofi/lit_compac_sky/doc/sizing/techsweep_sky130_fd_pr__nfet_01v8_plots_overview.pdf

−2

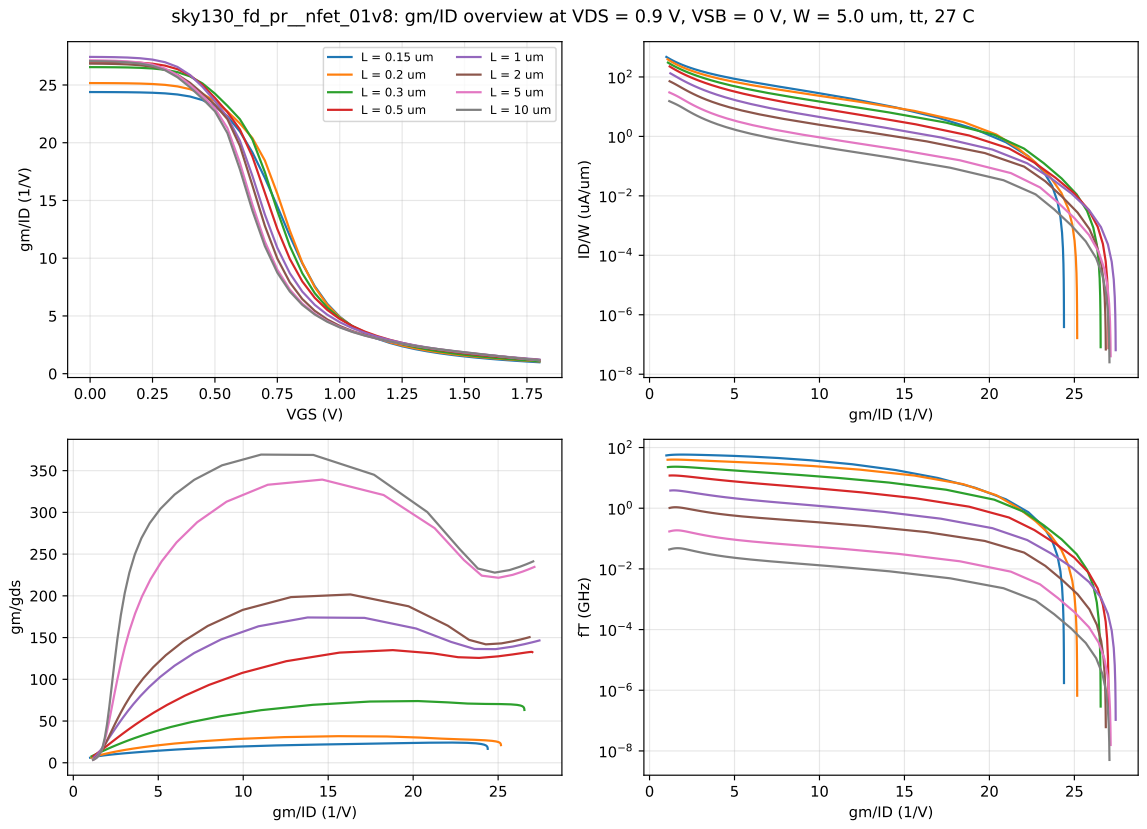
[picture p36: page 1]
VGS (V); gm/gds; fT (GHz)

sky130_fd_pr__nfet_01v8: gm/ID overview at VDS = 0.9 V, VSB = 0 V, W = 5.0 um, tt, 27 C
