santihofi/lit_compac_sky/doc/sizing/techsweep_sky130_fd_pr__nfet_g5v0d10v5_plots_overview.pdf

−3

−1

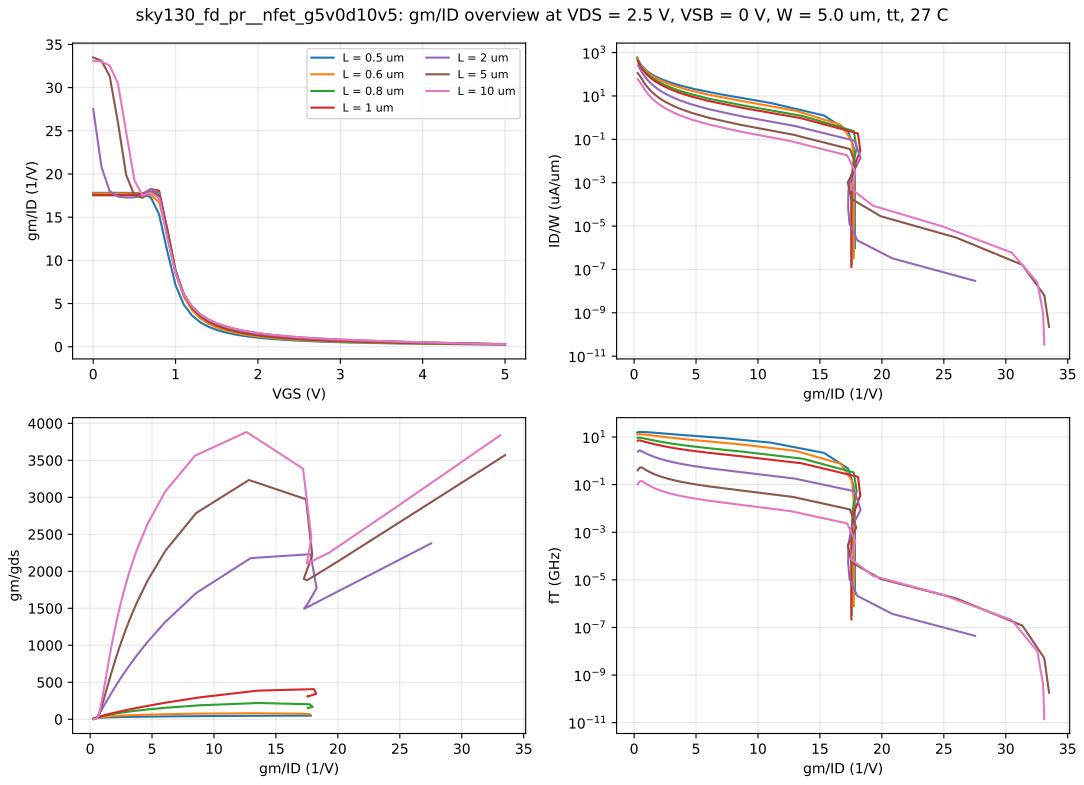
[picture p37: page 1]
VGS (V); gm/gds; fT (GHz)

sky130_fd_pr__nfet_g5v0d10v5: gm/ID overview at VDS = 2.5 V, VSB = 0 V, W = 5.0 um, tt, 27 C
