santihofi/lit_compac_sky/doc/sizing/techsweep_sky130_fd_pr__pfet_01v8_lvt_plots_overview.pdf

−2

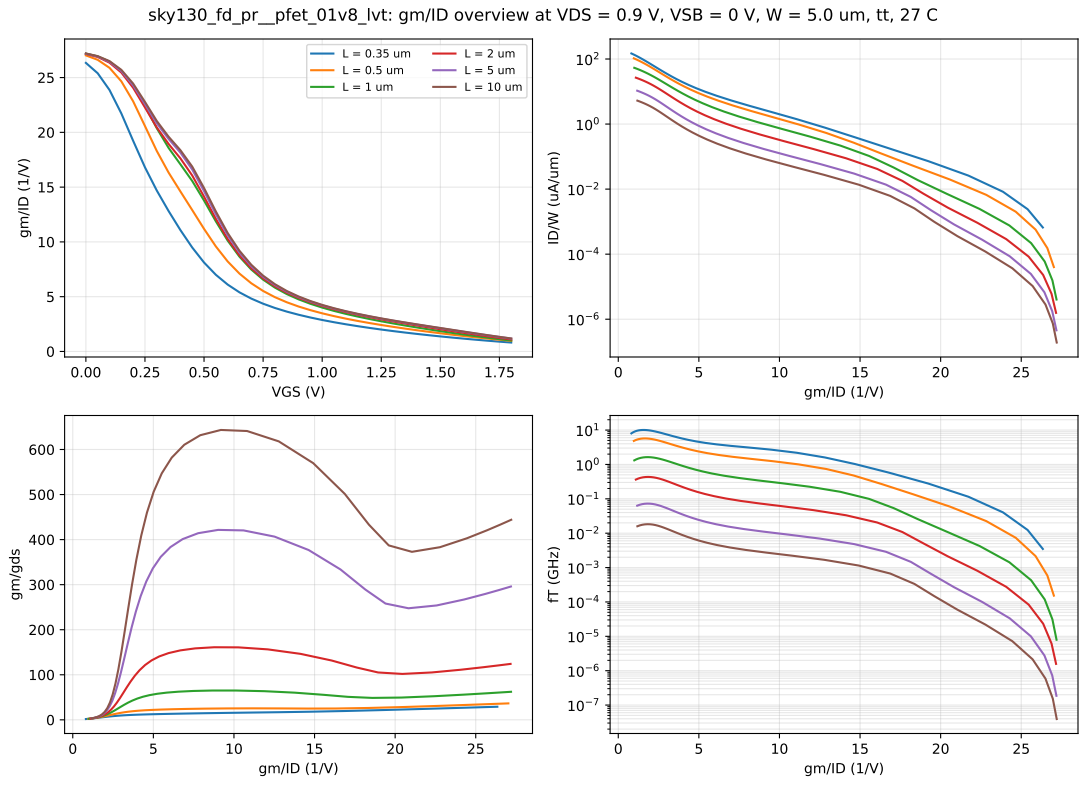
[picture p38: page 1]
VGS (V); gm/gds; fT (GHz)

sky130_fd_pr__pfet_01v8_lvt: gm/ID overview at VDS = 0.9 V, VSB = 0 V, W = 5.0 um, tt, 27 C
