santihofi/lit_compac_sky/doc/sizing/techsweep_sky130_fd_pr__pfet_g5v0d10v5_plots_overview.pdf

−4

−2

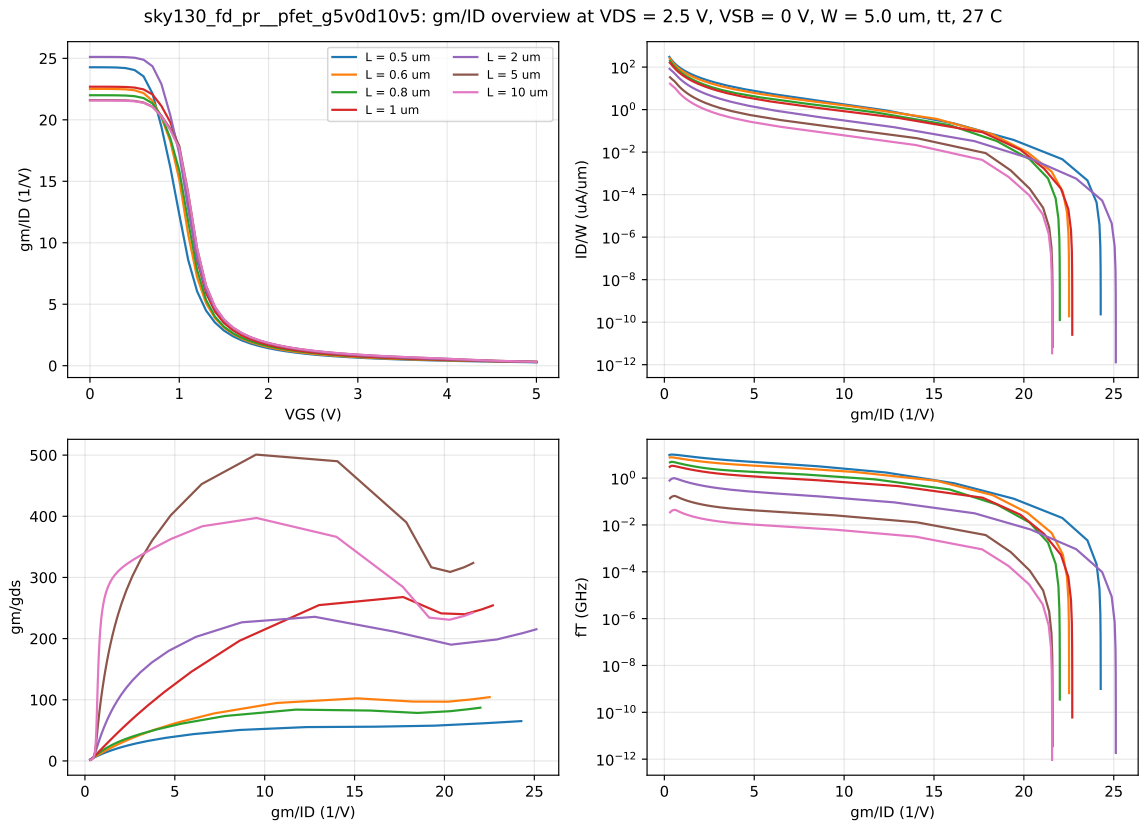
[picture p40: page 1]
VGS (V); gm/gds; fT (GHz)

sky130_fd_pr__pfet_g5v0d10v5: gm/ID overview at VDS = 2.5 V, VSB = 0 V, W = 5.0 um, tt, 27 C

L = 0.5 um | L = 2 um
L = 0.6 um L = 0.8 um L = 1 um | L = 5 um L = 10 um
