santihofi/lit_compac_sky/doc/porting/figures/replica_ihp_gain_steps.pdf

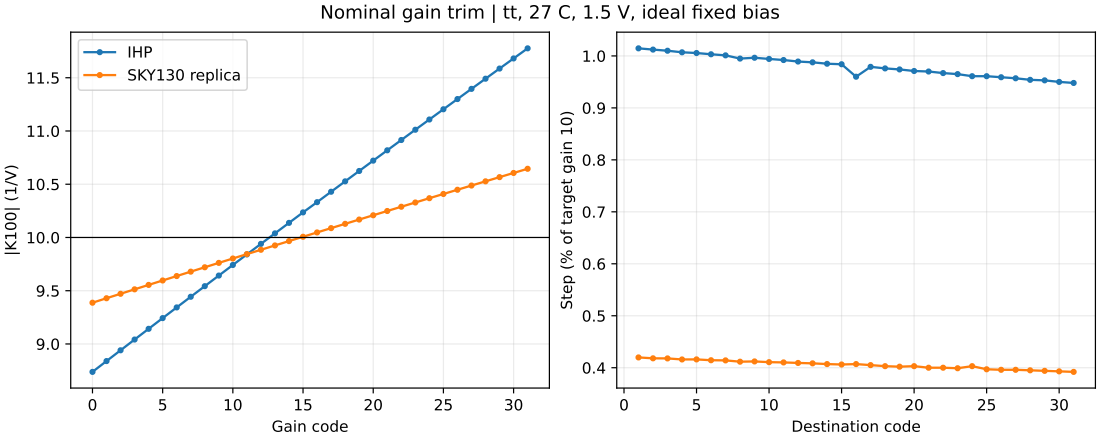
[picture p41: page 1]
Gain code; IHP SKY130 replica; Destination code

Nominal gain trim | tt, 27 C, 1.5 V, ideal fixed bias

Step (% of target gain 10)
