santihofi/lit_compac_sky/doc/porting/figures/tg2_nominal_code_coverage.pdf

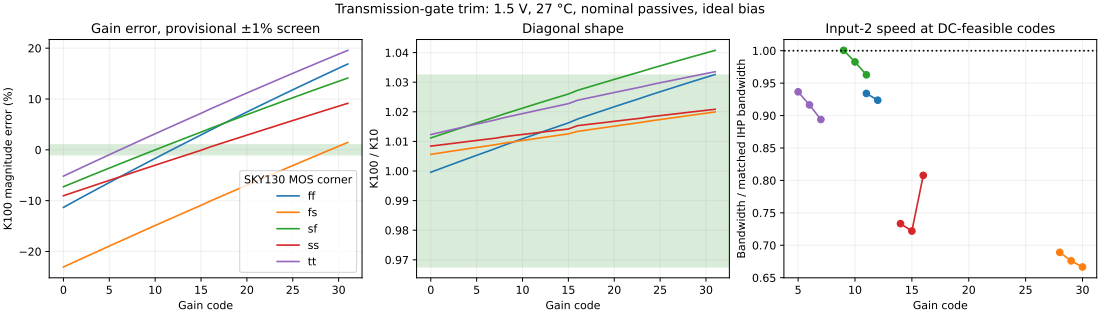
[picture p42: page 1]
Gain code; K100 magnitude error (%); Diagonal shape

Transmission-gate trim: 1.5 V, 27 °C, nominal passives, ideal bias

Gain error, provisional ±1% screen

Input-2 speed at DC-feasible codes

Bandwidth / matched IHP bandwidth

SKY130 MOS corner | ff
