santihofi/lit_compac_sky/doc/porting/figures/ihp_surface_corners.pdf

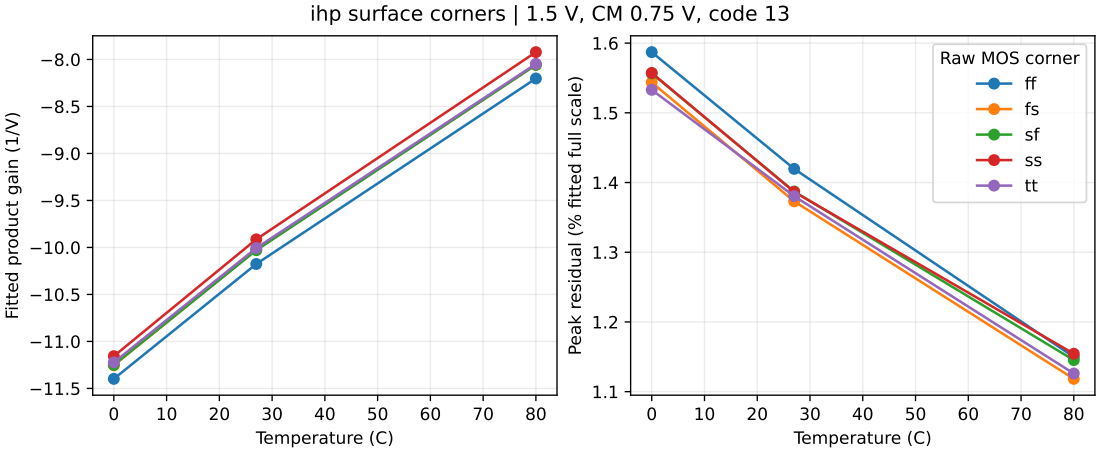
[picture p43: page 1]
Temperature (C); Peak residual (%

ihp surface corners | 1.5 V, CM 0.75 V, code 13

Raw MOS corner | ff fs

fitted full scale)

Fitted product gain (1/V)
