santihofi/lit_compac_sky/doc/porting/figures/replica_ihp_matched_surfaces.pdf

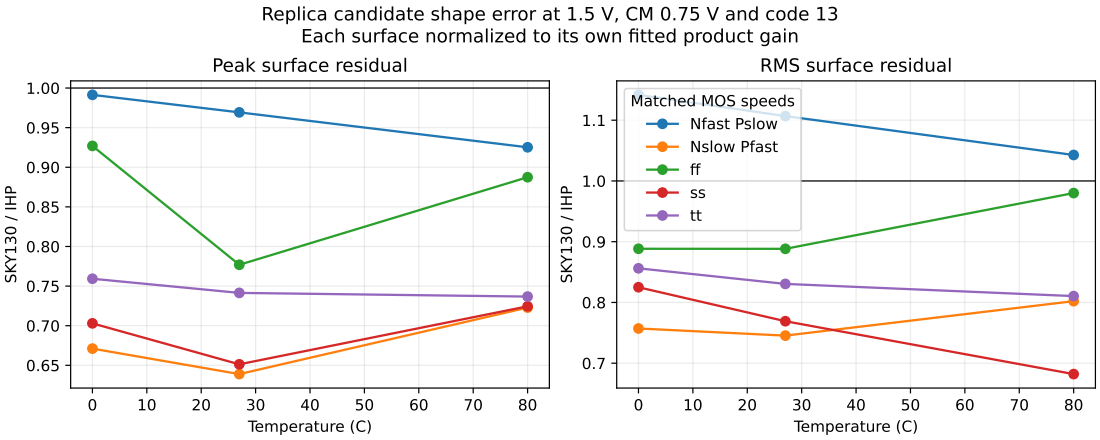
[picture p44: page 1]
Temperature (C); SKY130 / IHP

Replica candidate shape error at 1.5 V, CM 0.75 V and code 13
Each surface normalized to its own fitted product gain

Peak surface residual

RMS surface residual

Matched MOS speeds | Nfast Pslow

Nslow Pfast ff
