santihofi/lit_compac_sky/doc/porting/figures/sky_replica_loops.pdf

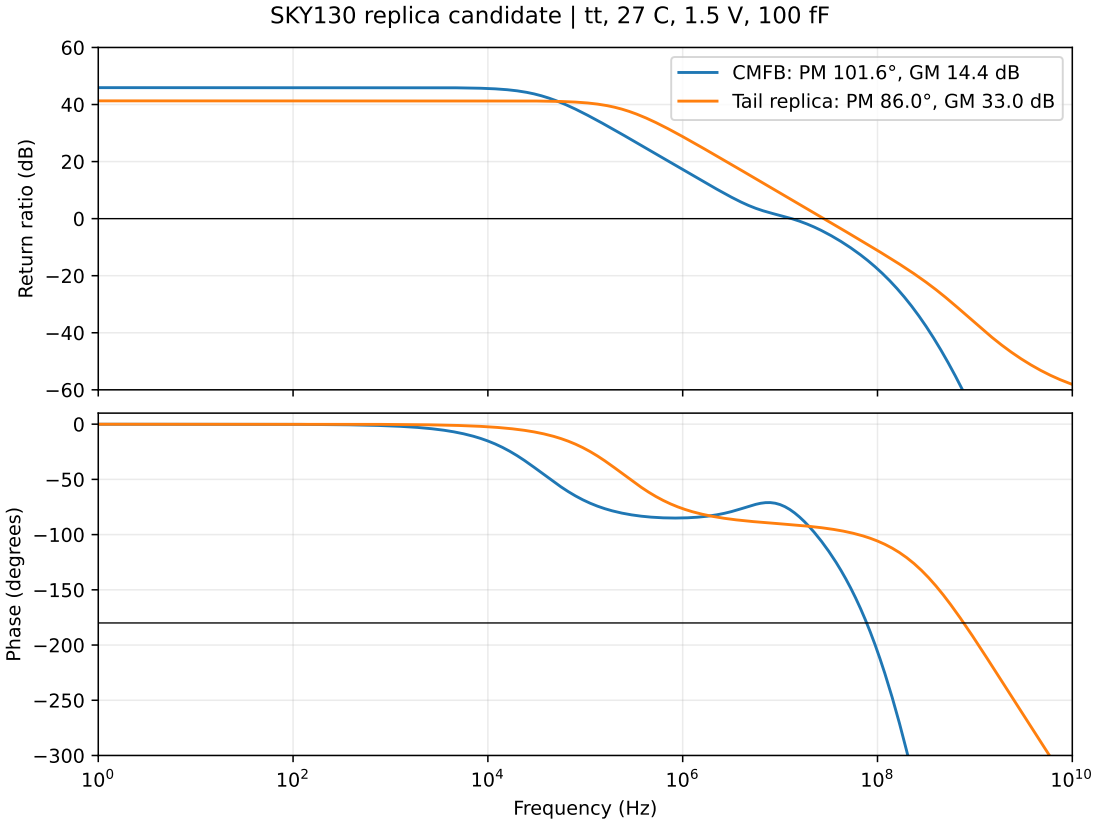
[picture p45: page 1]
Frequency (Hz); Phase (degrees)

SKY130 replica candidate | tt, 27 C, 1.5 V, 100 fF

CMFB: PM 101.6°, GM 14.4 dB
Tail replica: PM 86.0°, GM 33.0 dB

Return ratio (dB)
