santihofi/lit_compac_sky/doc/porting/figures/sky_cmfb_kick.pdf

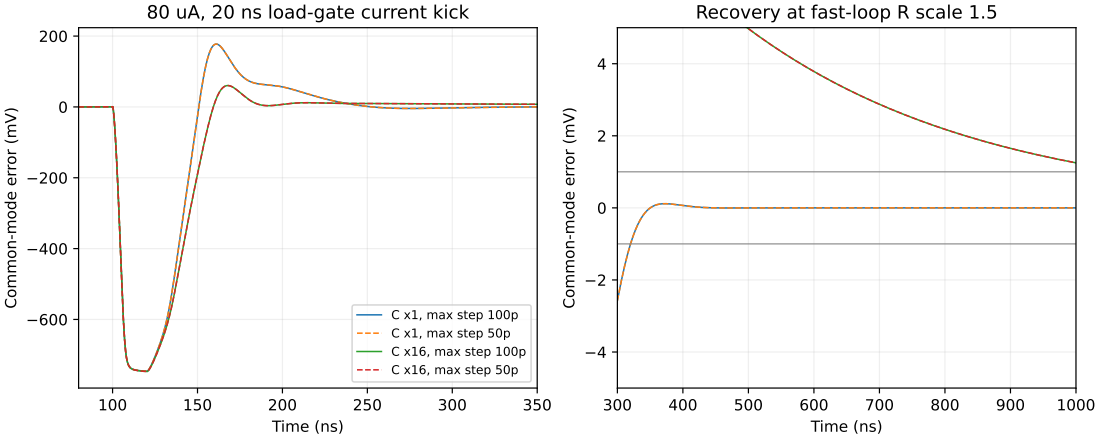
[picture p46: page 1]
Time (ns)

80 uA, 20 ns load-gate current kick

Recovery at fast-loop R scale 1.5

Common-mode error (mV)

C x1, max | step 100p
C x1, max C x16, max step 100p C x16, max step 50p | step 50p
