santihofi/lit_compac_sky/doc/porting/figures/matched_corner_comparison.pdf

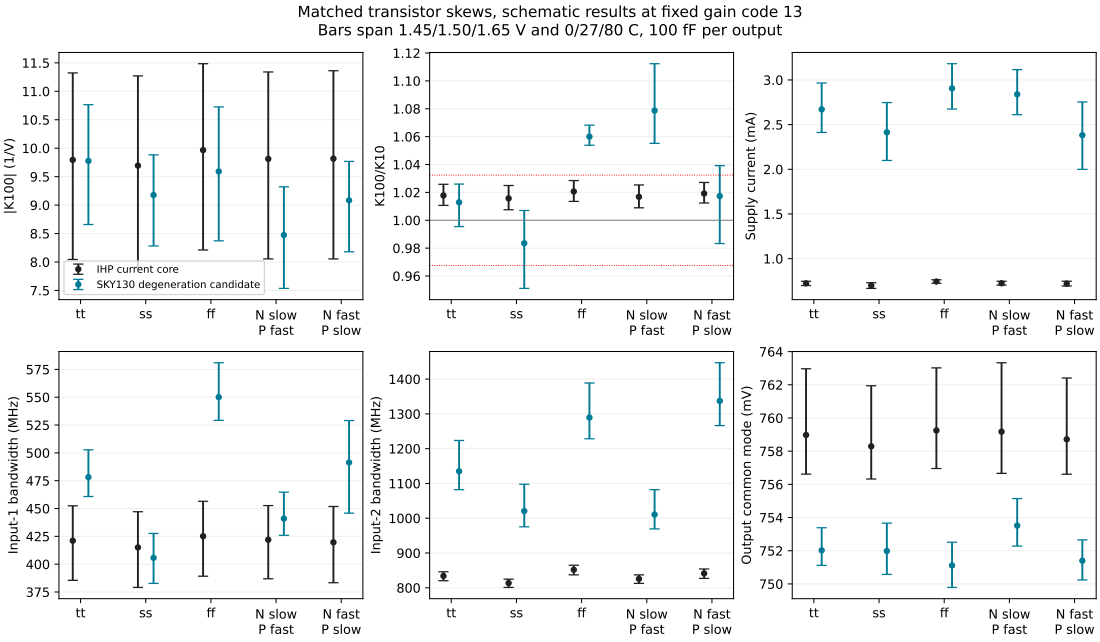
[picture p47: page 1]
N slow; P fast; N fast P slow

fixed gain code 13

Matched transistor skews, schematic results at
Bars span 1.45/1.50/1.65 V and 0/27/80 C, 100 fF per output

Supply current (mA)

IHP current core
SKY130 degeneration candidate

Output common mode (mV)

Input-1 bandwidth (MHz)

Input-2 bandwidth (MHz)
