santihofi/lit_compac_sky/doc/porting/figures/candidate_corners.pdf

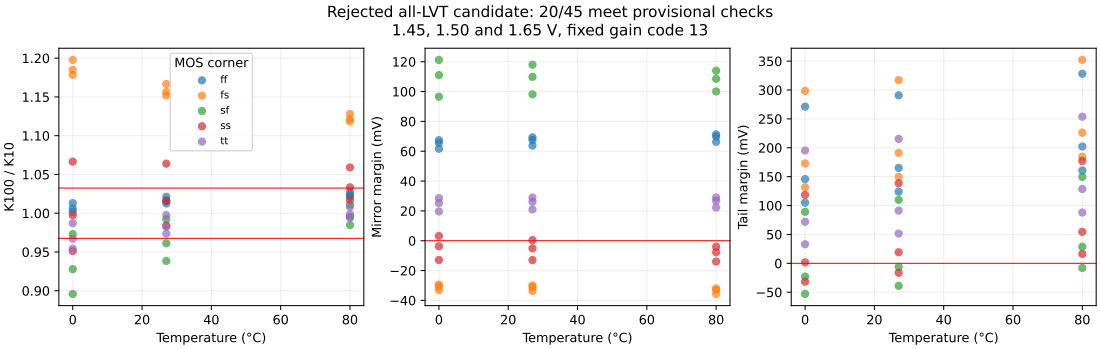
[picture p48: page 1]
Temperature (°C); Rejected all-LVT candidate: 20/45 meet provisional checks 1.45, 1.50 and 1.65 V,

fixed gain code 13

MOS corner ff | fs

Mirror margin (mV)

Tail margin (mV)
