santihofi/lit_compac_sky/doc/porting/figures/core_tradeoffs.pdf

### Schematic exploration at 1.5 V and 27 °C No candidate is qualified across corners

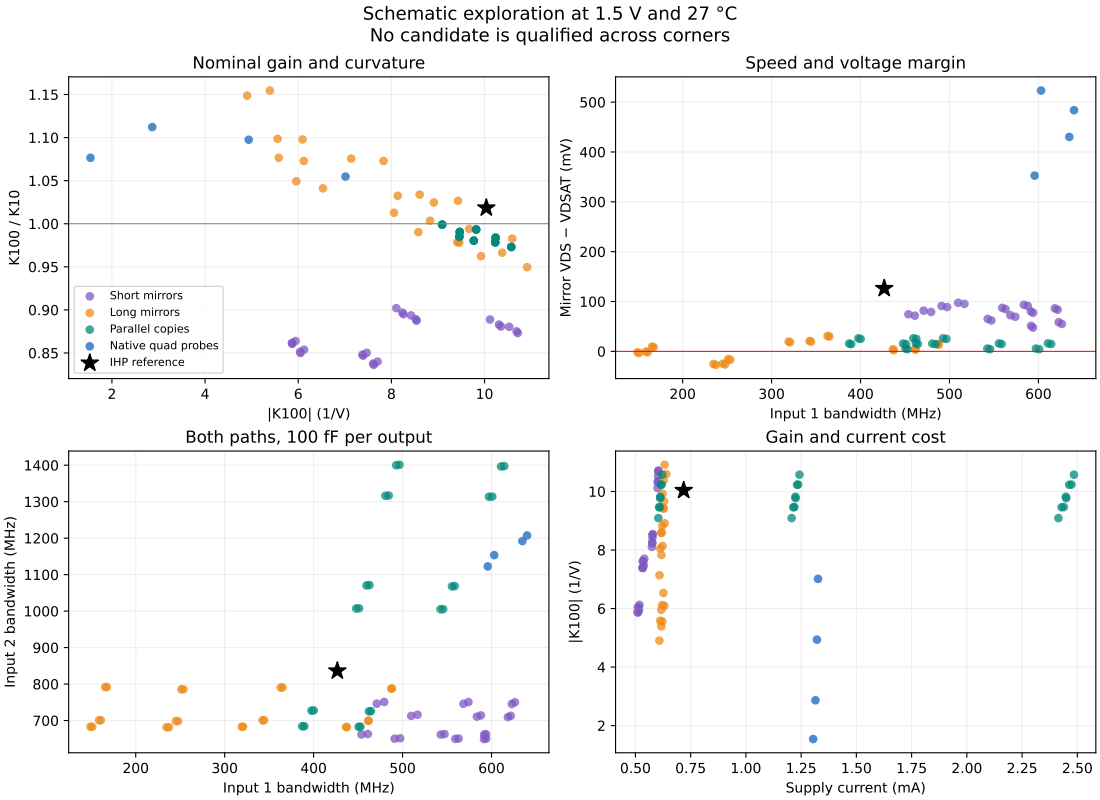
[picture p49: page 1]
Mirror VDS; − VDSAT (mV)

Nominal gain and curvature

Speed and voltage margin

Short mirrors
Long mirrors Parallel copies Native quad probes

IHP reference

Input 1 bandwidth (MHz)
Gain and current cost

Both paths, 100 fF per output

Input 2 bandwidth (MHz)

Supply current (mA)
