santihofi/lit_compac_sky/macros/counter/testbenches/xschem/plot_simulations/figures/counter_top_tb_tran.pdf

# Counter Top - Gate-Level Transient Simulation

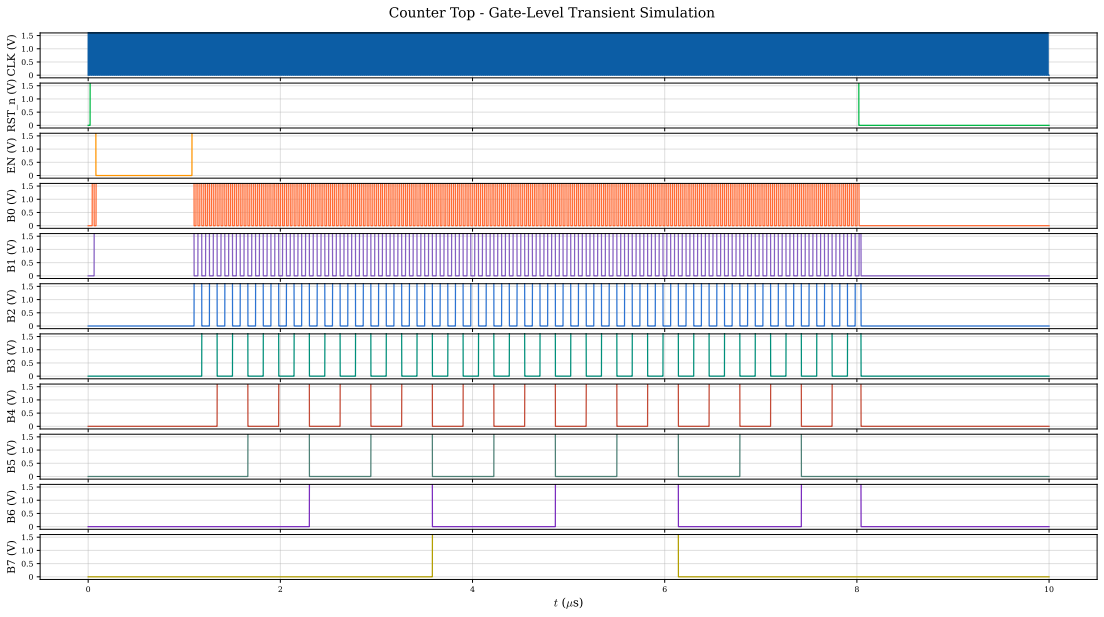
[picture p50: page 1]
CLK (V); RST_n (V)
