santihofi/lit_compac_sky/macros/inverter/testbenches/xschem/plot_simulations/figures/inverter_tb_dc_vout.pdf

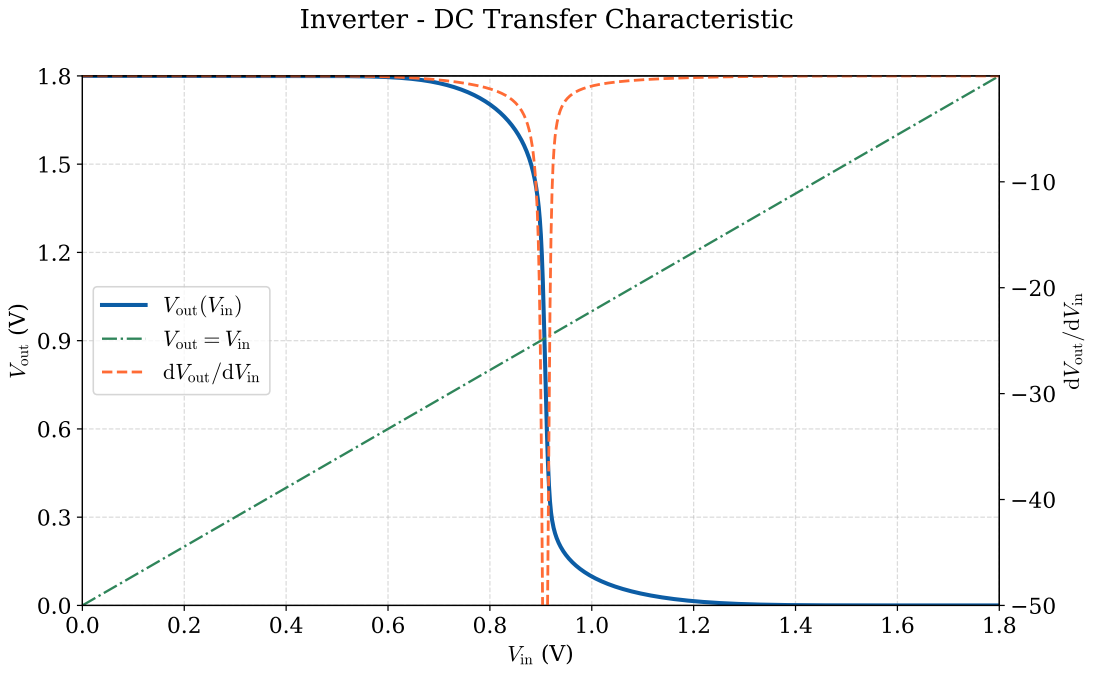
[picture p51: page 1]
Vin (V); Vout (V); Vout=; Vin

Inverter - DC Transfer Characteristic

Vout(Vin) Vout = Vin

dVout=dVin
