santihofi/lit_compac_sky/macros/inverter/testbenches/xschem/plot_simulations/figures/inverter_top_tb_tran.pdf

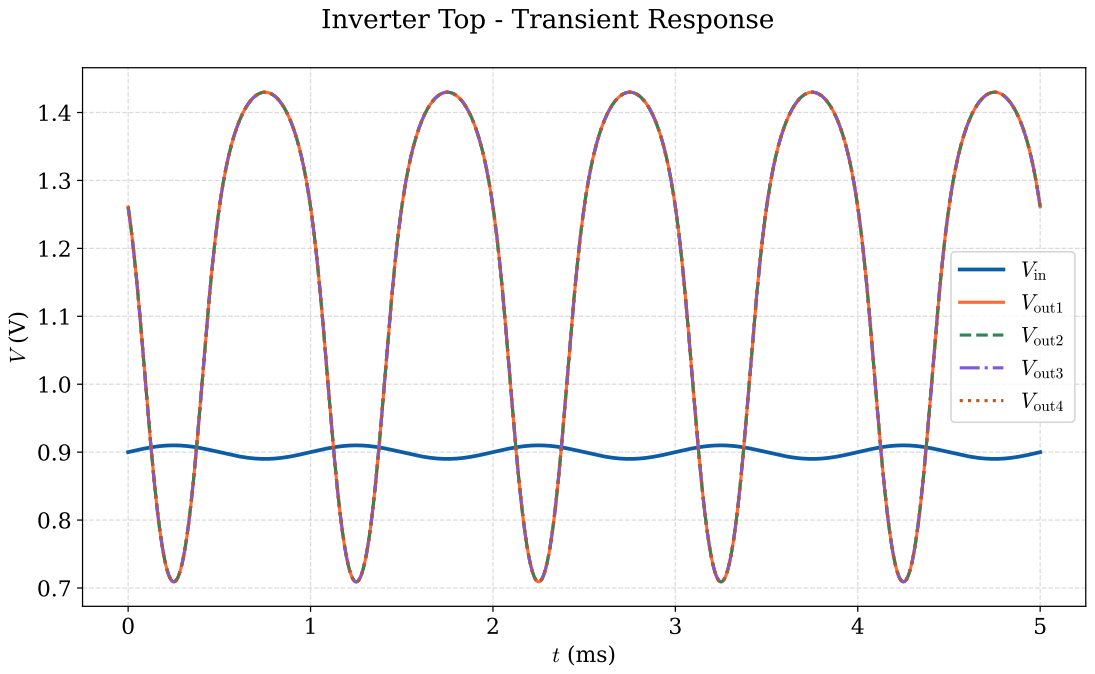
[picture p52: page 1]

Inverter Top - Transient Response

Vin Vout1

Vout2 Vout3

Vout4
