santihofi/lit_compac_sky/doc/porting/figures/sky_replica_kick.pdf

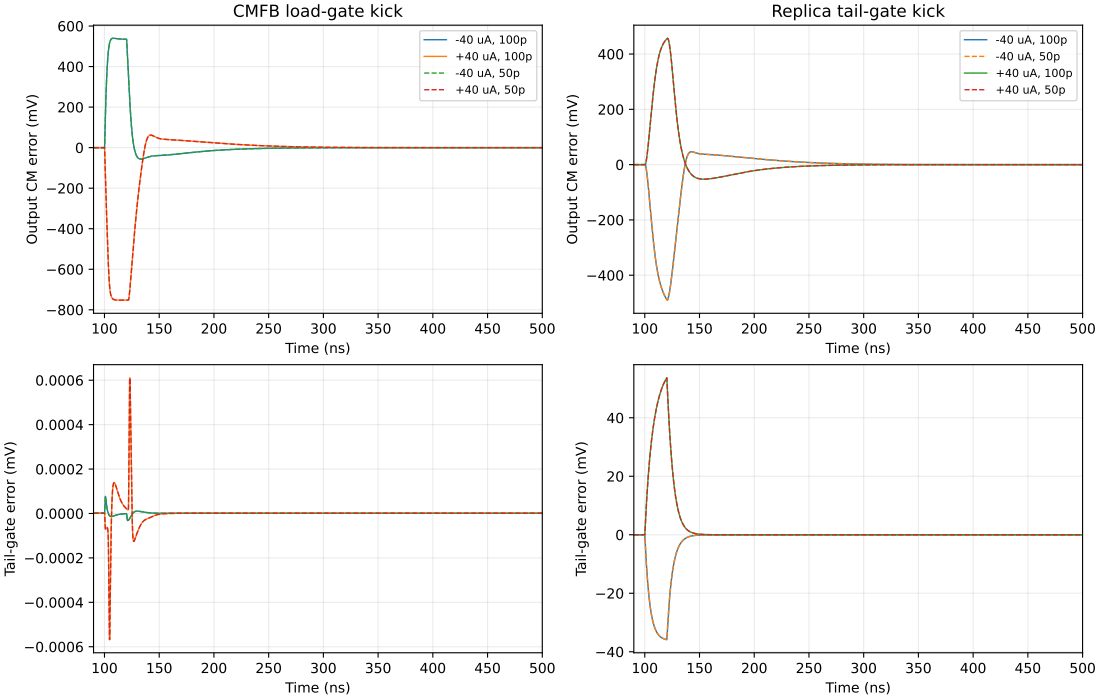
[picture p53: page 1]
Time (ns)

CMFB load-gate kick

Replica tail-gate kick

Output CM error (mV)

Tail-gate error (mV)
