santihofi/lit_compac_sky/macros/inverter/scripts/sizing/figures/inverter_circuit.pdf

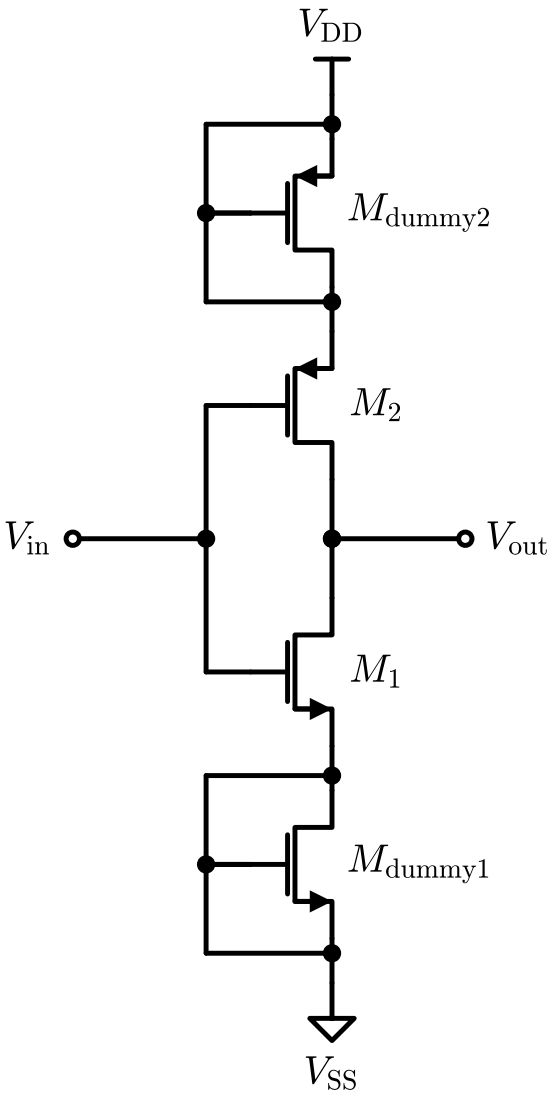
[picture p54: page 1]
Mdummy2; VDD; Mdummy1; VSS; Vin; Vout
