santihofi/lit_compac_sky/verification/porting/sky_input2_pair_calibration_ac/tb/fanout.spice

{% set trc = {'5p73': 68.05, '2p85': 130.36}[trim_family] %}
{% set trs = {'5p73': 56.46, '2p85': 113.56}[trim_family] %}
{% set taa = {'5p73': 0.0, '2p85': 20.618422702078476}[trim_family] %}
{% set rc = {'5p73': 68.05, '2p85': 130.36, '1p41': 254.77}[load_family] %}
{% set rs = {'5p73': 56.46, '2p85': 113.56, '1p41': 230.05}[load_family] %}
{% set aa = {'5p73': 0.0, '2p85': 20.618422702078476, '1p41': 46.08253447749805}[load_family] %}
{% set wanted_r = (68.05+56.46*13.035)*rscale*rbase_scale %}
** sch_path: /foss/designs/lit_compac_sky/verification/porting/sky_gilbert/tb/tb_gilbert_cell_mult.sch
**.subckt tb_gilbert_cell_mult
Vdd vdd GND {{vdd}}
.save i(vdd)
Vcmi vcmi GND {{vincm}}
Vref vref GND {{vref}}
I0 ibias GND {{ibias*power_m*bias_factor}}
I1 vdd ibias_ota {{ibias*power_m*bias_factor}}
Vd1 vdin1 GND {{vd1}}
E1 in1p vcmi VOL=' v(vdin1)/2 '
E2 in1n vcmi VOL=' -v(vdin1)/2 '
Vd2 vdin2 GND {{vd2}}
E4 in2p vcmi VOL=' v(vdin2)/2 '
E5 in2n vcmi VOL=' -v(vdin2)/2 '
x1 vdd vbias outp outn in1n in1p in2p in2n GND ibias vdd GND vcm_sense gt0 gt1 gt2 gt3 gt4 vref gilbert_cell
Cloadp outp GND 25f
Cloadn outn GND 25f
x2 vdd vbias vref vcm_sense GND ibias_ota vdd GND ota
Vgcode gcode GND {{gcode}}
Egt0 gt0 GND VOL=' v(vdd)*(1-(floor((v(gcode)+0.5)/1)-2*floor((v(gcode)+0.5)/2))) '
Egt1 gt1 GND VOL=' v(vdd)*(1-(floor((v(gcode)+0.5)/2)-2*floor((v(gcode)+0.5)/4))) '
Egt2 gt2 GND VOL=' v(vdd)*(1-(floor((v(gcode)+0.5)/4)-2*floor((v(gcode)+0.5)/8))) '
Egt3 gt3 GND VOL=' v(vdd)*(1-(floor((v(gcode)+0.5)/8)-2*floor((v(gcode)+0.5)/16))) '
Egt4 gt4 GND VOL=' v(vdd)*(1-(floor((v(gcode)+0.5)/16)-2*floor((v(gcode)+0.5)/32))) '
**** begin user architecture code


.temp {{ temp }}
.option SEED = {{ (seed|int) + 1 }}
.option method=gear

Vreceiver rvdd GND {{vdd}}
Votherp otherp vcmi 0.05
Vothern othern vcmi -0.05
Ireceiver ribias GND {{ibias*power_m*bias_factor}}
Ireceiver_ota rvdd ribias_ota {{ibias*power_m*bias_factor}}
xreceiver rvdd rvbias routp routn outn outp otherp othern GND ribias rvdd GND rvcm_sense gt0 gt1 gt2 gt3 gt4 vref gilbert_cell
xreceiver_cmfb rvdd rvbias vref rvcm_sense GND ribias_ota rvdd GND ota
Creceiverp routp GND 100f
Creceivern routn GND 100f
.control
save all
op
let idd=-i(vdd)
alter vd1 dc=0
alter vd2 dc=0.1
alter @vd1[acmag]=1
alter @vd2[acmag]=0
ac dec 60 1k 10g
let gd=v(outp)-v(outn)
let gd_db=20*log10(mag(gd)/mag(gd[0]))
meas ac bw1 when gd_db=-3
set bw1=$&bw1
let ag1=mag(gd[0])
set ag1=$&ag1
let ci1=-imag(i(e1)[180]-i(e2)[180])/(6.28318530718*frequency[180])*1e15
set ci1=$&ci1
let ci1hf=-imag(i(e1)[300]-i(e2)[300])/(6.28318530718*frequency[300])*1e15
set ci1hf=$&ci1hf
alter vd1 dc=0.1
alter vd2 dc=0
alter @vd1[acmag]=0
alter @vd2[acmag]=1
ac dec 60 1k 10g
let gd=v(outp)-v(outn)
let gd_db=20*log10(mag(gd)/mag(gd[0]))
meas ac bw2 when gd_db=-3
let loaded_bw_in1_mhz=$bw1/1e6
let loaded_bw_in2_mhz=bw2/1e6
let loaded_acgain_in1=$ag1
let loaded_acgain_in2=mag(gd[0])
let loaded_cin1_per_pin_ff=$ci1
let loaded_cin1_100mhz_ff=$ci1hf
let loaded_cin2_per_pin_ff=-imag(i(e4)[180]-i(e5)[180])/(6.28318530718*frequency[180])*1e15
let loaded_cin2_100mhz_ff=-imag(i(e4)[300]-i(e5)[300])/(6.28318530718*frequency[300])*1e15
let idd=op1.idd
quit
.endc





.lib /foss/pdks/sky130A/libs.tech/ngspice/sky130.lib.spice {{ corner_mos }}


**** end user architecture code
**.ends

* expanding   symbol:  lit_compac_sky/macros/gilbert_cell/schematic/xschem/gilbert_cell.sym # of pins=18
** sym_path: /foss/designs/lit_compac_sky/macros/gilbert_cell/schematic/xschem/gilbert_cell.sym
** sch_path: /foss/designs/lit_compac_sky/macros/gilbert_cell/schematic/xschem/gilbert_cell.sch



* expanding   symbol:  lit_compac_sky/macros/ota/schematic/xschem/ota.sym # of pins=8
** sym_path: /foss/designs/lit_compac_sky/macros/ota/schematic/xschem/ota.sym
** sch_path: /foss/designs/lit_compac_sky/macros/ota/schematic/xschem/ota.sch



* expanding   symbol:  lit_compac_sky/macros/gilbert_cell/schematic/xschem/gain_trim.sym # of pins=9
** sym_path: /foss/designs/lit_compac_sky/macros/gilbert_cell/schematic/xschem/gain_trim.sym
** sch_path: /foss/designs/lit_compac_sky/macros/gilbert_cell/schematic/xschem/gain_trim.sch


.GLOBAL GND
.subckt gilbert_cell vdd vbias outp outn in1n in1p in2p in2n vss ibias ntap ptap vcm gt0 gt1 gt2 gt3 gt4 replica_cm
*.iopin vdd
*.ipin in1n
*.opin outp
*.opin outn
*.iopin vss
*.ipin in1p
*.ipin in2n
*.ipin in2p
*.ipin vbias
*.ipin ibias
*.iopin ptap
*.opin vcm
*.iopin ntap
*.ipin gt0
*.ipin gt1
*.ipin gt2
*.ipin gt3
*.ipin gt4
XM5 qs1 net2 vss ptap sky130_fd_pr__nfet_01v8_lvt L={{mirror_l}} W={{20.0*mirror_scale}} nf={{(4*mirror_scale)|int}} ad={{(((4*mirror_scale+1)/2)|int)*5.0*0.29}} as={{(((4*mirror_scale+2)/2)|int)*5.0*0.29}} pd={{2*(((4*mirror_scale+1)/2)|int)*(5.0+0.29)}} ps={{2*(((4*mirror_scale+2)/2)|int)*(5.0+0.29)}} nrd={{0.29/(20.0*mirror_scale)}} nrs={{0.29/(20.0*mirror_scale)}} sa=0
+ sb=0 sd=0 mult={{1.0*power_m}} m={{1*power_m}}
XM6 qs2 net1 vss ptap sky130_fd_pr__nfet_01v8_lvt L={{mirror_l}} W={{20.0*mirror_scale}} nf={{(4*mirror_scale)|int}} ad={{(((4*mirror_scale+1)/2)|int)*5.0*0.29}} as={{(((4*mirror_scale+2)/2)|int)*5.0*0.29}} pd={{2*(((4*mirror_scale+1)/2)|int)*(5.0+0.29)}} ps={{2*(((4*mirror_scale+2)/2)|int)*(5.0+0.29)}} nrd={{0.29/(20.0*mirror_scale)}} nrs={{0.29/(20.0*mirror_scale)}} sa=0
+ sb=0 sd=0 mult={{1.0*power_m}} m={{1*power_m}}
XM7 outp in2n qd7 {{'qs1' if body_tied else 'ptap'}} sky130_fd_pr__{{quad_model}} L={{quad_l}} W={{(4*native_nf) if quad_model=='nfet_03v3_nvt' else (20.0*quad_scale)}} nf={{(native_nf) if quad_model=='nfet_03v3_nvt' else ((4*quad_scale)|int)}} ad={{((((native_nf+1)/2)|int)*4*0.29) if quad_model=='nfet_03v3_nvt' else ((((4*quad_scale+1)/2)|int)*5.0*0.29)}} as={{((((native_nf+2)/2)|int)*4*0.29) if quad_model=='nfet_03v3_nvt' else ((((4*quad_scale+2)/2)|int)*5.0*0.29)}} pd={{(2*(((native_nf+1)/2)|int)*4.29) if quad_model=='nfet_03v3_nvt' else (2*(((4*quad_scale+1)/2)|int)*(5.0+0.29))}} ps={{(2*(((native_nf+2)/2)|int)*4.29) if quad_model=='nfet_03v3_nvt' else (2*(((4*quad_scale+2)/2)|int)*(5.0+0.29))}} nrd={{0.29/((4*native_nf) if quad_model=='nfet_03v3_nvt' else (20.0*quad_scale))}} nrs={{0.29/((4*native_nf) if quad_model=='nfet_03v3_nvt' else (20.0*quad_scale))}} sa=0
+ sb=0 sd=0 mult={{1.0*power_m}} m={{1*power_m}}
XM9 outp in2p qd9 {{'qs2' if body_tied else 'ptap'}} sky130_fd_pr__{{quad_model}} L={{quad_l}} W={{(4*native_nf) if quad_model=='nfet_03v3_nvt' else (20.0*quad_scale)}} nf={{(native_nf) if quad_model=='nfet_03v3_nvt' else ((4*quad_scale)|int)}} ad={{((((native_nf+1)/2)|int)*4*0.29) if quad_model=='nfet_03v3_nvt' else ((((4*quad_scale+1)/2)|int)*5.0*0.29)}} as={{((((native_nf+2)/2)|int)*4*0.29) if quad_model=='nfet_03v3_nvt' else ((((4*quad_scale+2)/2)|int)*5.0*0.29)}} pd={{(2*(((native_nf+1)/2)|int)*4.29) if quad_model=='nfet_03v3_nvt' else (2*(((4*quad_scale+1)/2)|int)*(5.0+0.29))}} ps={{(2*(((native_nf+2)/2)|int)*4.29) if quad_model=='nfet_03v3_nvt' else (2*(((4*quad_scale+2)/2)|int)*(5.0+0.29))}} nrd={{0.29/((4*native_nf) if quad_model=='nfet_03v3_nvt' else (20.0*quad_scale))}} nrs={{0.29/((4*native_nf) if quad_model=='nfet_03v3_nvt' else (20.0*quad_scale))}} sa=0
+ sb=0 sd=0 mult={{1.0*power_m}} m={{1*power_m}}
XM10 outn in2n qd10 {{'qs2' if body_tied else 'ptap'}} sky130_fd_pr__{{quad_model}} L={{quad_l}} W={{(4*native_nf) if quad_model=='nfet_03v3_nvt' else (20.0*quad_scale)}} nf={{(native_nf) if quad_model=='nfet_03v3_nvt' else ((4*quad_scale)|int)}} ad={{((((native_nf+1)/2)|int)*4*0.29) if quad_model=='nfet_03v3_nvt' else ((((4*quad_scale+1)/2)|int)*5.0*0.29)}} as={{((((native_nf+2)/2)|int)*4*0.29) if quad_model=='nfet_03v3_nvt' else ((((4*quad_scale+2)/2)|int)*5.0*0.29)}} pd={{(2*(((native_nf+1)/2)|int)*4.29) if quad_model=='nfet_03v3_nvt' else (2*(((4*quad_scale+1)/2)|int)*(5.0+0.29))}} ps={{(2*(((native_nf+2)/2)|int)*4.29) if quad_model=='nfet_03v3_nvt' else (2*(((4*quad_scale+2)/2)|int)*(5.0+0.29))}} nrd={{0.29/((4*native_nf) if quad_model=='nfet_03v3_nvt' else (20.0*quad_scale))}} nrs={{0.29/((4*native_nf) if quad_model=='nfet_03v3_nvt' else (20.0*quad_scale))}} sa=0
+ sb=0 sd=0 mult={{1.0*power_m}} m={{1*power_m}}
XM8 outn in2p qd8 {{'qs1' if body_tied else 'ptap'}} sky130_fd_pr__{{quad_model}} L={{quad_l}} W={{(4*native_nf) if quad_model=='nfet_03v3_nvt' else (20.0*quad_scale)}} nf={{(native_nf) if quad_model=='nfet_03v3_nvt' else ((4*quad_scale)|int)}} ad={{((((native_nf+1)/2)|int)*4*0.29) if quad_model=='nfet_03v3_nvt' else ((((4*quad_scale+1)/2)|int)*5.0*0.29)}} as={{((((native_nf+2)/2)|int)*4*0.29) if quad_model=='nfet_03v3_nvt' else ((((4*quad_scale+2)/2)|int)*5.0*0.29)}} pd={{(2*(((native_nf+1)/2)|int)*4.29) if quad_model=='nfet_03v3_nvt' else (2*(((4*quad_scale+1)/2)|int)*(5.0+0.29))}} ps={{(2*(((native_nf+2)/2)|int)*4.29) if quad_model=='nfet_03v3_nvt' else (2*(((4*quad_scale+2)/2)|int)*(5.0+0.29))}} nrd={{0.29/((4*native_nf) if quad_model=='nfet_03v3_nvt' else (20.0*quad_scale))}} nrs={{0.29/((4*native_nf) if quad_model=='nfet_03v3_nvt' else (20.0*quad_scale))}} sa=0
+ sb=0 sd=0 mult={{1.0*power_m}} m={{1*power_m}}
XM11 outp vbias vdd ntap sky130_fd_pr__pfet_01v8_lvt L={{pload_l}} W={{32.0*pload_l}} nf=8 ad={{4*(4.0*pload_l)*0.29}} as={{5*(4.0*pload_l)*0.29}} pd={{8*((4.0*pload_l)+0.29)}} ps={{10*((4.0*pload_l)+0.29)}} nrd={{0.29/(32.0*pload_l)}} nrs={{0.29/(32.0*pload_l)}}
+ sa=0 sb=0 sd=0 mult={{1.0*power_m}} m={{1*power_m}}
XM12 outn vbias vdd ntap sky130_fd_pr__pfet_01v8_lvt L={{pload_l}} W={{32.0*pload_l}} nf=8 ad={{4*(4.0*pload_l)*0.29}} as={{5*(4.0*pload_l)*0.29}} pd={{8*((4.0*pload_l)+0.29)}} ps={{10*((4.0*pload_l)+0.29)}} nrd={{0.29/(32.0*pload_l)}} nrs={{0.29/(32.0*pload_l)}}
+ sa=0 sb=0 sd=0 mult={{1.0*power_m}} m={{1*power_m}}
XM1 net1 in1n ps1 {{'ps1' if pair_body_tied else 'ntap'}} sky130_fd_pr__pfet_01v8_lvt L={{pair_l}} W={{74.625*pair_scale}} nf={{(12*pair_scale)|int}} ad={{(((12*pair_scale+1)/2)|int)*6.21875*0.29}} as={{(((12*pair_scale+2)/2)|int)*6.21875*0.29}} pd={{2*(((12*pair_scale+1)/2)|int)*(6.21875+0.29)}} ps={{2*(((12*pair_scale+2)/2)|int)*(6.21875+0.29)}}
+ nrd={{0.29/(74.625*pair_scale)}} nrs={{0.29/(74.625*pair_scale)}} sa=0 sb=0 sd=0 mult={{1.0*power_m}} m={{1*power_m}}
XM13 vcm1 ibias vdd ntap sky130_fd_pr__pfet_01v8_lvt L={{0.65*tail_length_scale}} W={{40.0*(tail_width*tail_length_scale)}} nf={{(4*(tail_width*tail_length_scale))|int}} ad={{(((4*(tail_width*tail_length_scale)+1)/2)|int)*10.0*0.29}} as={{(((4*(tail_width*tail_length_scale)+2)/2)|int)*10.0*0.29}} pd={{2*(((4*(tail_width*tail_length_scale)+1)/2)|int)*(10.0+0.29)}} ps={{2*(((4*(tail_width*tail_length_scale)+2)/2)|int)*(10.0+0.29)}} nrd={{0.29/(40.0*(tail_width*tail_length_scale))}} nrs={{0.29/(40.0*(tail_width*tail_length_scale))}} sa=0
+ sb=0 sd=0 mult={{8.0*power_m}} m={{8.0*power_m}}
XM3 net1 net1 vss ptap sky130_fd_pr__nfet_01v8_lvt L={{mirror_l}} W={{20.0*mirror_scale}} nf={{(4*mirror_scale)|int}} ad={{(((4*mirror_scale+1)/2)|int)*5.0*0.29}} as={{(((4*mirror_scale+2)/2)|int)*5.0*0.29}} pd={{2*(((4*mirror_scale+1)/2)|int)*(5.0+0.29)}} ps={{2*(((4*mirror_scale+2)/2)|int)*(5.0+0.29)}} nrd={{0.29/(20.0*mirror_scale)}} nrs={{0.29/(20.0*mirror_scale)}} sa=0
+ sb=0 sd=0 mult={{1.0*power_m}} m={{1*power_m}}
XM4 net2 net2 vss ptap sky130_fd_pr__nfet_01v8_lvt L={{mirror_l}} W={{20.0*mirror_scale}} nf={{(4*mirror_scale)|int}} ad={{(((4*mirror_scale+1)/2)|int)*5.0*0.29}} as={{(((4*mirror_scale+2)/2)|int)*5.0*0.29}} pd={{2*(((4*mirror_scale+1)/2)|int)*(5.0+0.29)}} ps={{2*(((4*mirror_scale+2)/2)|int)*(5.0+0.29)}} nrd={{0.29/(20.0*mirror_scale)}} nrs={{0.29/(20.0*mirror_scale)}} sa=0
+ sb=0 sd=0 mult={{1.0*power_m}} m={{1*power_m}}
XM2 net2 in1p ps2 {{'ps2' if pair_body_tied else 'ntap'}} sky130_fd_pr__pfet_01v8_lvt L={{pair_l}} W={{74.625*pair_scale}} nf={{(12*pair_scale)|int}} ad={{(((12*pair_scale+1)/2)|int)*6.21875*0.29}} as={{(((12*pair_scale+2)/2)|int)*6.21875*0.29}} pd={{2*(((12*pair_scale+1)/2)|int)*(6.21875+0.29)}} ps={{2*(((12*pair_scale+2)/2)|int)*(6.21875+0.29)}}
+ nrd={{0.29/(74.625*pair_scale)}} nrs={{0.29/(74.625*pair_scale)}} sa=0 sb=0 sd=0 mult={{1.0*power_m}} m={{1*power_m}}
XM14 rvcm1 ibias vdd ntap sky130_fd_pr__pfet_01v8_lvt L={{0.65*tail_length_scale}} W={{40.0*(tail_width*tail_length_scale)}} nf={{(4*(tail_width*tail_length_scale))|int}} ad={{(((4*(tail_width*tail_length_scale)+1)/2)|int)*10.0*0.29}} as={{(((4*(tail_width*tail_length_scale)+2)/2)|int)*10.0*0.29}} pd={{2*(((4*(tail_width*tail_length_scale)+1)/2)|int)*(10.0+0.29)}} ps={{2*(((4*(tail_width*tail_length_scale)+2)/2)|int)*(10.0+0.29)}} nrd={{0.29/(40.0*(tail_width*tail_length_scale))}} nrs={{0.29/(40.0*(tail_width*tail_length_scale))}}
+ sa=0 sb=0 sd=0 mult={{1.0*power_m}} m={{1*power_m}}
Rtap_R1 vss ptap 1m
XR7 t4p outp ptap sky130_fd_pr__res_high_po_{{load_family}} L={{((wanted_r-rc)+((wanted_r-rc)**2-4*rs*aa)**0.5)/(2*rs)}} mult={{1.0*power_m}} m={{1*power_m}}
XR5 outn t4n ptap sky130_fd_pr__res_high_po_{{load_family}} L={{((wanted_r-rc)+((wanted_r-rc)**2-4*rs*aa)**0.5)/(2*rs)}} mult={{1.0*power_m}} m={{1*power_m}}
Rtap_R2 vdd ntap 1m
xtrim t4p t4n vcm gt0 gt1 gt2 gt3 gt4 ptap ntap gain_trim
XMDP vcm1 vcm1 vcm1 {{'vcm1' if pair_body_tied else 'ntap'}} sky130_fd_pr__pfet_01v8_lvt L={{pair_l}} W={{24.875*1}} nf={{(4*1)|int}} ad={{(((4*1+1)/2)|int)*6.21875*0.29}} as={{(((4*1+2)/2)|int)*6.21875*0.29}} pd={{2*(((4*1+1)/2)|int)*(6.21875+0.29)}} ps={{2*(((4*1+2)/2)|int)*(6.21875+0.29)}}
+ nrd={{0.29/(24.875*1)}} nrs={{0.29/(24.875*1)}} sa=0 sb=0 sd=0 mult={{1.0*power_m}} m={{1*power_m}}
XMDM vss vss vss ptap sky130_fd_pr__nfet_01v8_lvt L={{mirror_l}} W={{10.0*mirror_scale}} nf={{(2*mirror_scale)|int}} ad={{(((2*mirror_scale+1)/2)|int)*5.0*0.29}} as={{(((2*mirror_scale+2)/2)|int)*5.0*0.29}} pd={{2*(((2*mirror_scale+1)/2)|int)*(5.0+0.29)}} ps={{2*(((2*mirror_scale+2)/2)|int)*(5.0+0.29)}} nrd={{0.29/(10.0*mirror_scale)}} nrs={{0.29/(10.0*mirror_scale)}} sa=0 sb=0
+ sd=0 mult={{1.0*power_m}} m={{1*power_m}}
XMDQ1 qs1 qs1 qs1 {{'qs1' if body_tied else 'ptap'}} sky130_fd_pr__{{quad_model}} L={{quad_l}} W={{(4*native_nf) if quad_model=='nfet_03v3_nvt' else (20.0*quad_scale)}} nf={{(native_nf) if quad_model=='nfet_03v3_nvt' else ((4*quad_scale)|int)}} ad={{((((native_nf+1)/2)|int)*4*0.29) if quad_model=='nfet_03v3_nvt' else ((((4*quad_scale+1)/2)|int)*5.0*0.29)}} as={{((((native_nf+2)/2)|int)*4*0.29) if quad_model=='nfet_03v3_nvt' else ((((4*quad_scale+2)/2)|int)*5.0*0.29)}} pd={{(2*(((native_nf+1)/2)|int)*4.29) if quad_model=='nfet_03v3_nvt' else (2*(((4*quad_scale+1)/2)|int)*(5.0+0.29))}} ps={{(2*(((native_nf+2)/2)|int)*4.29) if quad_model=='nfet_03v3_nvt' else (2*(((4*quad_scale+2)/2)|int)*(5.0+0.29))}} nrd={{0.29/((4*native_nf) if quad_model=='nfet_03v3_nvt' else (20.0*quad_scale))}} nrs={{0.29/((4*native_nf) if quad_model=='nfet_03v3_nvt' else (20.0*quad_scale))}} sa=0
+ sb=0 sd=0 mult={{1.0*power_m}} m={{1*power_m}}
XMDQ2 qs2 qs2 qs2 {{'qs2' if body_tied else 'ptap'}} sky130_fd_pr__{{quad_model}} L={{quad_l}} W={{(4*native_nf) if quad_model=='nfet_03v3_nvt' else (20.0*quad_scale)}} nf={{(native_nf) if quad_model=='nfet_03v3_nvt' else ((4*quad_scale)|int)}} ad={{((((native_nf+1)/2)|int)*4*0.29) if quad_model=='nfet_03v3_nvt' else ((((4*quad_scale+1)/2)|int)*5.0*0.29)}} as={{((((native_nf+2)/2)|int)*4*0.29) if quad_model=='nfet_03v3_nvt' else ((((4*quad_scale+2)/2)|int)*5.0*0.29)}} pd={{(2*(((native_nf+1)/2)|int)*4.29) if quad_model=='nfet_03v3_nvt' else (2*(((4*quad_scale+1)/2)|int)*(5.0+0.29))}} ps={{(2*(((native_nf+2)/2)|int)*4.29) if quad_model=='nfet_03v3_nvt' else (2*(((4*quad_scale+2)/2)|int)*(5.0+0.29))}} nrd={{0.29/((4*native_nf) if quad_model=='nfet_03v3_nvt' else (20.0*quad_scale))}} nrs={{0.29/((4*native_nf) if quad_model=='nfet_03v3_nvt' else (20.0*quad_scale))}} sa=0
+ sb=0 sd=0 mult={{1.0*power_m}} m={{1*power_m}}
XMDL vdd vdd vdd ntap sky130_fd_pr__pfet_01v8_lvt L={{pload_l}} W={{16.0*pload_l}} nf=4 ad={{2*(4.0*pload_l)*0.29}} as={{3*(4.0*pload_l)*0.29}} pd={{4*((4.0*pload_l)+0.29)}} ps={{6*((4.0*pload_l)+0.29)}} nrd={{0.29/(16.0*pload_l)}} nrs={{0.29/(16.0*pload_l)}} sa=0
+ sb=0 sd=0 mult={{1.0*power_m}} m={{1*power_m}}
XMDT vdd vdd vdd ntap sky130_fd_pr__pfet_01v8_lvt L={{0.65*tail_length_scale}} W={{20.0*(tail_width*tail_length_scale)}} nf={{(2*(tail_width*tail_length_scale))|int}} ad={{(((2*(tail_width*tail_length_scale)+1)/2)|int)*10.0*0.29}} as={{(((2*(tail_width*tail_length_scale)+2)/2)|int)*10.0*0.29}} pd={{2*(((2*(tail_width*tail_length_scale)+1)/2)|int)*(10.0+0.29)}} ps={{2*(((2*(tail_width*tail_length_scale)+2)/2)|int)*(10.0+0.29)}} nrd={{0.29/(20.0*(tail_width*tail_length_scale))}} nrs={{0.29/(20.0*(tail_width*tail_length_scale))}} sa=0 sb=0
+ sd=0 mult={{1.0*power_m}} m={{1*power_m}}
XRD1 ntap ntap ptap sky130_fd_pr__res_high_po_{{load_family}} L={{((wanted_r-rc)+((wanted_r-rc)**2-4*rs*aa)**0.5)/(2*rs)}} mult={{1.0*power_m}} m={{1*power_m}}
XRD2 ntap ntap ptap sky130_fd_pr__res_high_po_{{load_family}} L={{((wanted_r-rc)+((wanted_r-rc)**2-4*rs*aa)**0.5)/(2*rs)}} mult={{1.0*power_m}} m={{1*power_m}}
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
