santihofi/lit_compac_sky/macros/counter/final/nl/counter_top.nl.v

module counter_top (clock_i,
    enable_i,
    reset_n_i,
    counter_value_o);
 input clock_i;
 input enable_i;
 input reset_n_i;
 output [7:0] counter_value_o;

 wire _00_;
 wire _01_;
 wire _02_;
 wire _03_;
 wire _04_;
 wire _05_;
 wire _06_;
 wire _07_;
 wire _08_;
 wire _09_;
 wire _10_;
 wire _11_;
 wire _12_;
 wire _13_;
 wire _14_;
 wire _15_;
 wire _16_;
 wire _17_;
 wire _18_;
 wire _19_;
 wire _20_;
 wire _21_;
 wire _22_;
 wire _23_;
 wire _24_;
 wire _25_;
 wire _26_;
 wire _27_;
 wire _28_;
 wire _29_;
 wire _30_;
 wire _31_;
 wire _32_;
 wire _33_;
 wire _34_;
 wire net3;
 wire net4;
 wire net5;
 wire net6;
 wire net7;
 wire net8;
 wire net9;
 wire net10;
 wire net1;
 wire net2;
 wire clknet_0_clock_i;
 wire clknet_1_0__leaf_clock_i;
 wire clknet_1_1__leaf_clock_i;
 wire net11;
 wire net12;

 sky130_fd_sc_hd__decap_3 FILLER_0_109 ();
 sky130_fd_sc_hd__decap_12 FILLER_0_113 ();
 sky130_fd_sc_hd__decap_12 FILLER_0_125 ();
 sky130_fd_sc_hd__decap_3 FILLER_0_137 ();
 sky130_fd_sc_hd__decap_12 FILLER_0_141 ();
 sky130_fd_sc_hd__decap_12 FILLER_0_15 ();
 sky130_fd_sc_hd__decap_12 FILLER_0_153 ();
 sky130_fd_sc_hd__decap_3 FILLER_0_165 ();
 sky130_fd_sc_hd__decap_12 FILLER_0_169 ();
 sky130_fd_sc_hd__decap_12 FILLER_0_181 ();
 sky130_fd_sc_hd__decap_3 FILLER_0_193 ();
 sky130_fd_sc_hd__decap_12 FILLER_0_197 ();
 sky130_fd_sc_hd__decap_12 FILLER_0_209 ();
 sky130_fd_sc_hd__decap_3 FILLER_0_221 ();
 sky130_fd_sc_hd__decap_12 FILLER_0_225 ();
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
 sky130_fd_sc_hd__buf_2 output6 (.A(net6),
    .X(counter_value_o[3]));
 sky130_fd_sc_hd__buf_2 output7 (.A(net7),
    .X(counter_value_o[4]));
 sky130_fd_sc_hd__buf_2 output8 (.A(net8),
    .X(counter_value_o[5]));
 sky130_fd_sc_hd__buf_2 output9 (.A(net9),
    .X(counter_value_o[6]));
endmodule
