santihofi/lit_compac_sky/(commit log)

2026-10-28 Initialize from SKY130 AMS template a84f451
    [chip_pad_bidir.sch, chip_pad_in.sch, chip_pad_out.sch, chip_top.sch, chip_top_tb_tran.sch, counter_top_tb_tran.csv, counter_top_tb_tran.sch, inverter.sch]
2026-10-28 Start multiplier port with staged plan and reproduced IHP baseline
    Initialize the template project, retain source and tool provenance, and distinguish measured nominal multiplier behavior from pending SKY130 qualification.
    [chip_pad_bidir.sch, chip_pad_in.sch, chip_pad_out.sch, chip_top.sch, chip_top_tb_tran.sch, ihp_nominal_multiplier.csv, lit_compac_top.sch, lit_compac_top_tb_tran.sch]
2026-10-29 Characterize the initial SKY130 core and audit the current IHP reference
    Record primitive models, headroom-limited sizing candidates, current-design PVT and bandwidth baselines, explicit simulator initialization and independent result-integrity checks. The port remains in schematic qualification.
    [gain_trim.sch, gilbert_cell.sch, ihp_corners_multiplier.csv, ihp_nominal_bandgap.csv, ihp_nominal_bias_channel.csv, ihp_nominal_mult_cell.csv, ihp_nominal_mult_tile.csv, ota.sch]
2026-10-29 Measure SKY130 statistical activation and core speed tradeoffs
    Retain independent controls for deterministic, mismatch and process models and correct the inherited template process Monte Carlo selection. Record equal-load IHP bandwidth, two core sizing sweeps and reproducible parallel-scaling exploration.
    [ihp_core_identical_load.csv, inverter_tb_ac.csv, sky_core_long_mirror.csv, sky_core_short_mirror.csv, sky_resistor_multiplicity.csv, sky_sizing_quad.csv, sky_statistics_mismatch.csv, sky_statistics_off.csv]
2026-10-29 Reject the all-LVT corner candidate and probe native quad devices
    Record 45 valid corner cases and the failing headroom and curvature limits. Add native geometry controls, measured model bins, parallel-scaling evidence and comparison plots. Keep data-integrity validation distinct from specification failures.
    [sky_body_quad.csv, sky_candidate_corners.csv, sky_core_parallel_scaling.csv, sky_native_quad.csv, sky_native_sizing.csv, sky_statistics_combined.csv]
2026-10-30 Measure SKY130 degeneration and current IHP noise and stability
    Reject native and degenerated candidates at process corners. Correct skew-corner matching and retain reproducible noise, loop and transfer benches with independent validity audits.
    [ihp_core_corners.csv, ihp_core_noise.csv, ihp_core_stability.csv, sky_cmfb_resistor_sizing.csv, sky_corner_identity.csv, sky_degenerated_corners.csv, sky_degenerated_noise.csv, sky_degenerated_refine.csv]
2026-10-30 Compare full transfer surfaces and isolate input curvature
    Retain both 1681-point surfaces, matched-skew plots and the 120-case sizing sweep. Validate DC convergence aids and record the nominal CMFB capacitor experiment without claiming corner qualification.
    [ihp_core_transfer_surface.csv, sky_cmfb_capacitor_sizing.csv, sky_curvature_sizing.csv, sky_degenerated_transfer_surface.csv]
2026-10-30 Measure CMFB recovery and quantized bias calibration
    Keep higher-voltage alternatives distinct, compare input loading and document reproduction. Correct transient metadata auditing and retain complete current-kick traces.
    [ihp_input_capacitance.csv, sky_bias_calibration_nominal.csv, sky_cmfb_drive_sizing.csv, sky_cmfb_kick.csv, sky_cmfb_load_sizing.csv, sky_curvature_bias_sizing.csv, sky_curvature_quad_sizing.csv, sky_higher_cm_corners.csv]
2026-10-31 Locate calibrated-candidate corner failures in tail compliance
    Retain the improved nominal transfer surface and the 33-of-45 corner result. Start a modeled input-pair degeneration experiment without promoting a failed circuit to layout.
    [sky_bias_calibration_pvt.csv, sky_calibrated_transfer_surface.csv, sky_higher_cm_mirror_refine.csv]
2026-10-31 Retain pair-degeneration controls and clarify noise save behavior
    Record the cold-corner headroom tradeoff and prove that save all preserves noise output while a selective voltage save suppresses it.
    [calibration_probe.yaml, sky_pair_degeneration_sizing.csv]
2026-10-31 Measure pair degeneration loading and recover compact-core bandwidth
    Retain 42-of-45 large-pair PVT results and reject its bandwidth cost. Add audited compact-device and short-load sweeps, plus an RC control for managed AC capture after repeated operating points.
    [sky_compact_load_sizing.csv, sky_compact_pair_sizing.csv, sky_pair_degenerated_ac.csv, sky_pair_degenerated_pvt.csv, sky_pair_degeneration_bias.csv]
2026-11-01 Qualify compact-core nominal behavior and expose remaining PVT failures
    Measure full surfaces, noise, loop margins and actual next-core loading. Retain all 45 calibrated corner cases and anchor AC curves to scalar measurements to detect wrong-plot exports.
    [ihp_core_fanout.csv, sky_compact_fanout.csv, sky_compact_load_bias.csv, sky_compact_noise.csv, sky_compact_pvt.csv, sky_compact_stability.csv, sky_compact_transfer_surface.csv]
2026-11-02 Isolate compact-core current-mirror compliance and model limits
    Retain geometry and well-tie controls, add active and replica mirror diagnostics, and record the 0.35 um LVT PMOS model minimum.
    [sky_compact_compliance.csv, sky_compact_mirror_recovery.csv]
2026-11-02 Measure active and replica tail-reference controls
    Retain the physical voltage-domain rejection for an ideal-amplifier root and the measured replica tracking errors before calibrated PVT.
    [sky_regulated_tail_bias.csv, sky_replica_tail_bias.csv]
2026-11-02 Record the first replica candidate passing the 45-case curvature screen
    Retain nominal transfer, noise, AC and both return ratios. Prepare independent fixed-code corner checks while keeping schematic and physical qualification open.
    [sky_replica_ac.csv, sky_replica_bias_loop.csv, sky_replica_cmfb.csv, sky_replica_noise.csv, sky_replica_pvt.csv, sky_replica_transfer_surface.csv]
2026-11-02 Audit replica bandwidth and both feedback loops across 45 corners
    Retain scalar-anchored waveforms and expose the input-2 speed shortfall against IHP. Prepare matched corner surfaces and receiver loading without promoting the candidate to an accepted schematic.
    [sky_replica_ac_pvt.csv, sky_replica_bias_loop_pvt.csv, sky_replica_cmfb_pvt.csv]
2026-11-02 Compare replica surface corners and transistor receiver loading
    Retain fifteen surfaces per PDK and expose the mixed RMS result after semantic skew mapping. Measure all four replica fanout loads and prepare gain-trim endpoint checks.
    [ihp_surface_corners.csv, replica_ihp_matched_surfaces.csv, sky_replica_fanout.csv, sky_replica_surface_corners.csv]
2026-11-02 Draw and replay the replica schematic and track the updated IHP interface
    Prove the 132-instance view against the characterized source and replay nominal measurements. Retain a separate geometry-grid control and follow the source's new 512-bit readout-DAC architecture.
    [gain_trim.sch, gilbert_cell.sch, ota.sch, sky_replica_grid_ac.csv, sky_replica_grid_noise.csv, sky_replica_grid_replica.csv, sky_replica_grid_transfer.csv, sky_replica_grid_transfer_surface.csv]
2026-11-02 Measure gain-trim coverage and correct the IHP trim-drive comparison
    Separate historical fixed-rail results from VDD-tracking controls, retain endpoint limits, and record the nominal geometry-grid control. Redraw the OTA resistor chain with explicit series wires and preserve the verified connectivity.
    [ihp_gain_trim.csv, ihp_midcode_rails.csv, ota.sch, replica_ihp_gain_endpoint_coverage.csv, sky_replica_gain_trim.csv]
2026-11-02 Measure nominal trim steps and separate fixed load from trim range
    [ihp_gain_trim_nominal_steps.csv, sky_replica_gain_trim_nominal_steps.csv, sky_replica_trim_range_initial.csv]
2026-11-03 Calibrate the wider replica trim and verify nominal loop recovery
    [calibrated_ff.yaml, calibrated_fs.yaml, calibrated_sf.yaml, calibrated_ss.yaml, calibrated_tt.yaml, ihp_gain_calibration.csv, sky_centered_gain_calibration.csv, sky_replica_kick.csv]
2026-11-03 Reject the wider trim at PVT and verify passive model selection
    [calibrated_pvt_matched.csv, ihp_calibrated_pvt.csv, sky_centered_ac.csv, sky_centered_dc.csv, sky_gain_dc_sweep_control.csv, sky_trim_gate_ac.csv, sky_trim_gate_dc.csv]
2026-11-03 Measure mid-rail switch conductance and reject minimum-length shortcut
    [sky_trim_switch_lengths.csv, sky_trim_switch_lengths_curves.csv, sky_trim_switch_probe.csv, sky_trim_switch_probe_curves.csv]
2026-11-03 Record PMOS and transmission-gate trim endpoint coverage
    [sky_trim_pmos4_endpoints.csv, sky_trim_tg2_endpoints.csv]
2026-11-03 Evaluate trim feasibility per PVT corner
    Allow unused codes to fail and retain fixed-code sweeps as drift evidence. Add exhaustive code screens and explicit provisional gain tolerance.
    [sky_wide_codes_nominal.csv]
2026-11-03 Record joint nominal code feasibility for the wider trim
2026-11-09 Measure joint gain and bandwidth coverage for transmission-gate trim
    [sky_tg2_codes_nominal.csv, sky_tg2_feasible_ac.csv]
2026-11-09 Improve input-2 bandwidth with narrower fixed-load resistors
    [sky_input2_load_resistors.csv, sky_input2_speed.csv]
2026-11-09 Close the slow-corner loaded bandwidth gap with common-mode replica bias
    Validate six-copy nominal speed and quantify the power cost. Preserve the fractional-finger diagnostic, release replay and completed PVT provenance.
    [ihp_input2_fanout.csv, ihp_input2_fanout6.csv, input2_fanout6_matched.csv, input2_fanout_matched.csv, sky_input2_candidate_control.csv, sky_input2_candidate_nominal5.csv, sky_input2_candidate_nominal6.csv, sky_input2_fanout.csv]
2026-11-10 Select nominal quiet-replica codes and finish trim PVT audit
    [ihp_input2_quiet_corners.csv, input2_quiet_corners_matched.csv, input2_quiet_selected_nominal.csv, sky_input2_quiet_corners.csv, sky_input2_quiet_ss_codes.csv, sky_tg2_codes_pvt.csv]
2026-11-10 Qualify nominal quiet-replica loops and start exhaustive PVT screen
    [sky_input2_quiet_loops.csv]
2026-11-11 Audit quiet-replica PVT code coverage and remaining failures
    [sky_quiet_codes_pvt.csv]
2026-11-11 Probe current sensitivity at uncovered quiet-replica PVT points
2026-11-11 Record six PVT recoveries from quiet-replica bias adjustment
    [sky_quiet_bias_sensitivity.csv]
2026-11-11 Refine quiet-replica calibration and screen remaining trim-range gaps
    [sky_quiet_refine.csv]
2026-11-11 Validate all baseline parameters when combining calibration evidence
2026-11-11 Record resistor-range endpoints and select a global candidate
    [sky_quiet_range.csv]
2026-11-11 Sweep gain codes for the global widened resistor candidate
2026-11-11 Record ten-point DC coverage for the widened resistor network
    [sky_quiet_range14.csv]
2026-11-11 Record nominal bandwidth loss from the widened trim network
    [sky_quiet_range14_ac.csv]
2026-11-11 Recover FS bandwidth with resistance-matched narrow trim poly
    [sky_quiet_trim_poly.csv]
2026-11-12 Verify narrow-trim corner speed and search remaining SS calibration
    [sky_quiet_trim_corners.csv]
2026-11-12 Resolve the sampled SS gain and current feasibility grid
    [sky_trim_ss_bias.csv]
2026-11-12 Audit SS speed limits and recalibrate reduced input-pair loading
    [calibrate_ss.yaml, sky_input2_pair_width.csv, sky_trim_ss_bias_ac.csv]
2026-11-13 Recover matched-gain SS bandwidth and screen global smaller-pair range
    [sky_input2_pair_calibration.csv, sky_input2_pair_calibration_ac.csv]
2026-11-13 Record smaller-pair endpoint deficits and expand global trim screen
    [sky_input2_pair_endpoints.csv]
2026-11-13 Select global trim factor 1.7 for smaller-pair code qualification
    [sky_input2_pair_trim_range.csv]
